Bonafide116/rfsom01/Hardware/Documents/Scheme-it-export-SOM-ZYNQ-2025-08-24-23-59.png

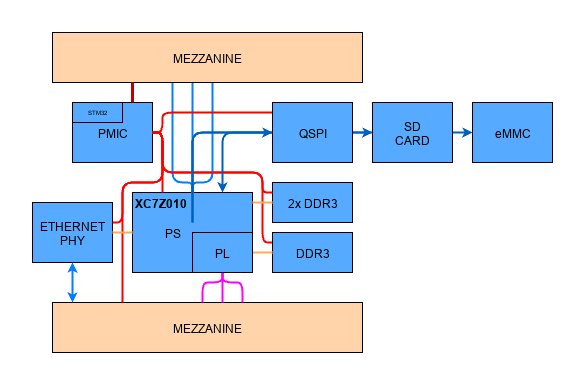
Hardware/Documents/Scheme-it-export-SOM-ZYNQ-2025-08-24-23-59.png
