Bonafide116/rfsom01/Hardware/Project Outputs/Documentation/Schematics/[WIP] RFSOM 01.pdf

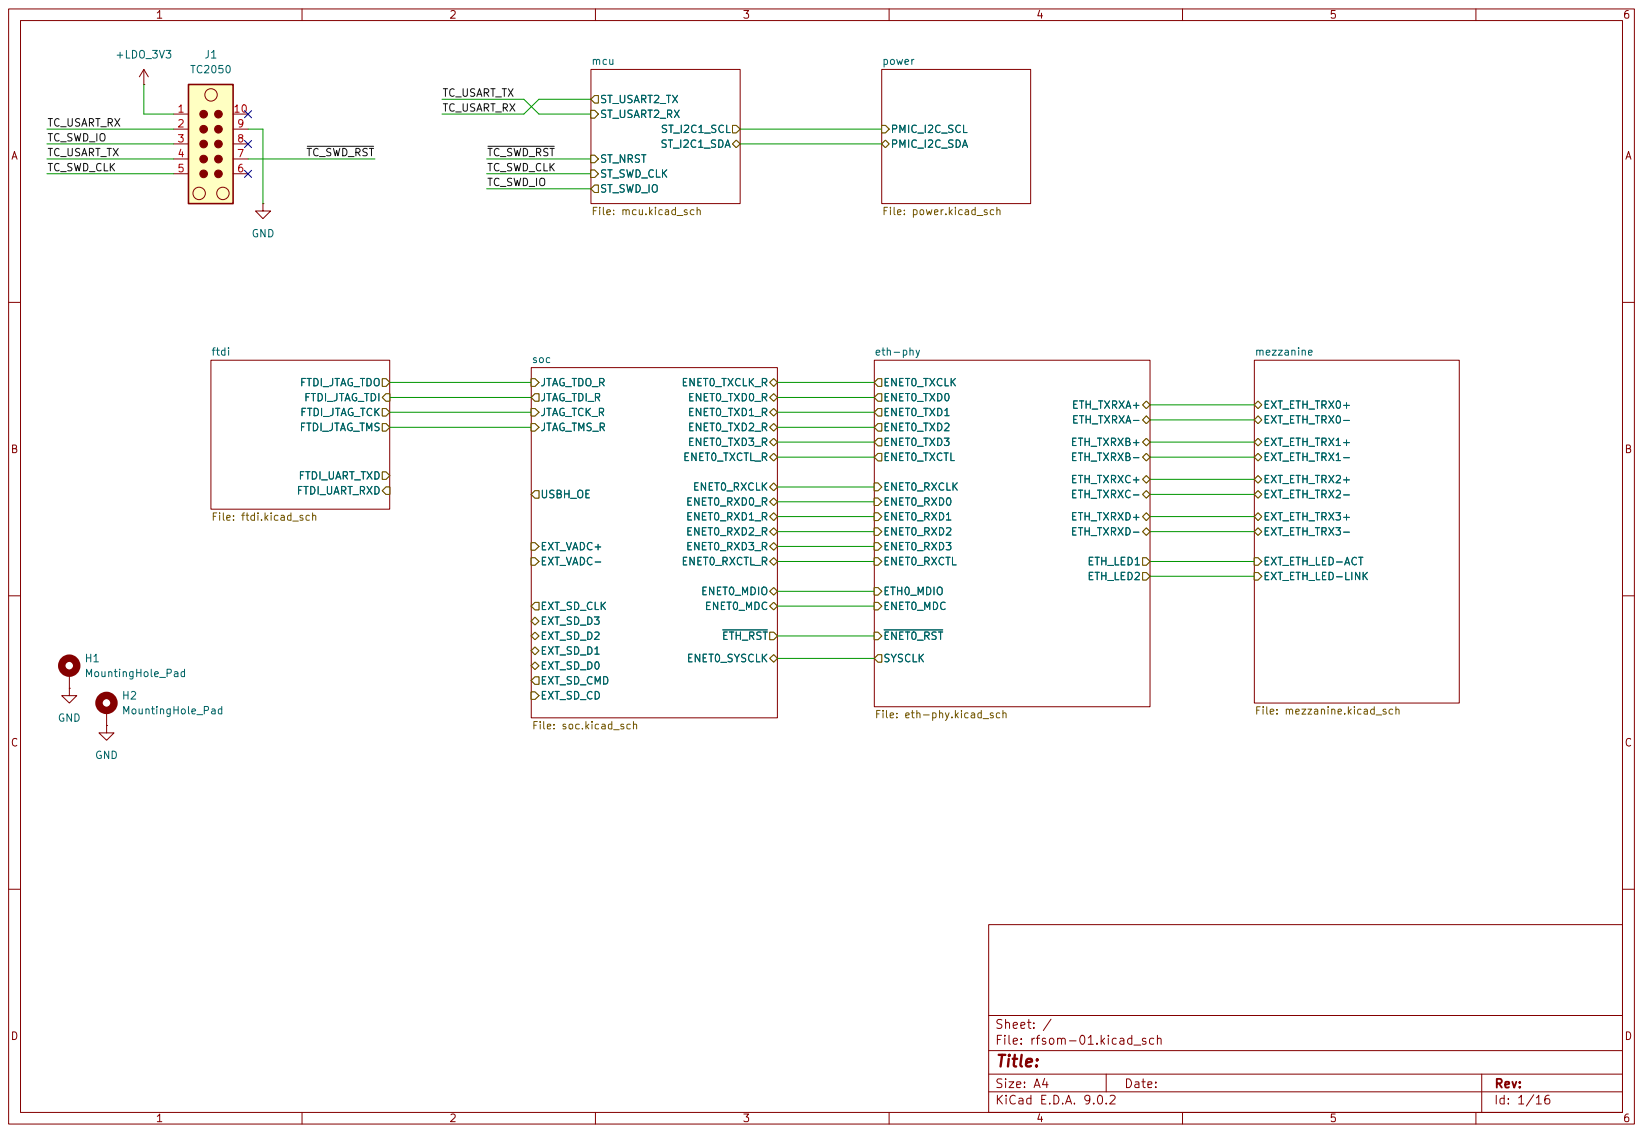
[picture p2: page 1]

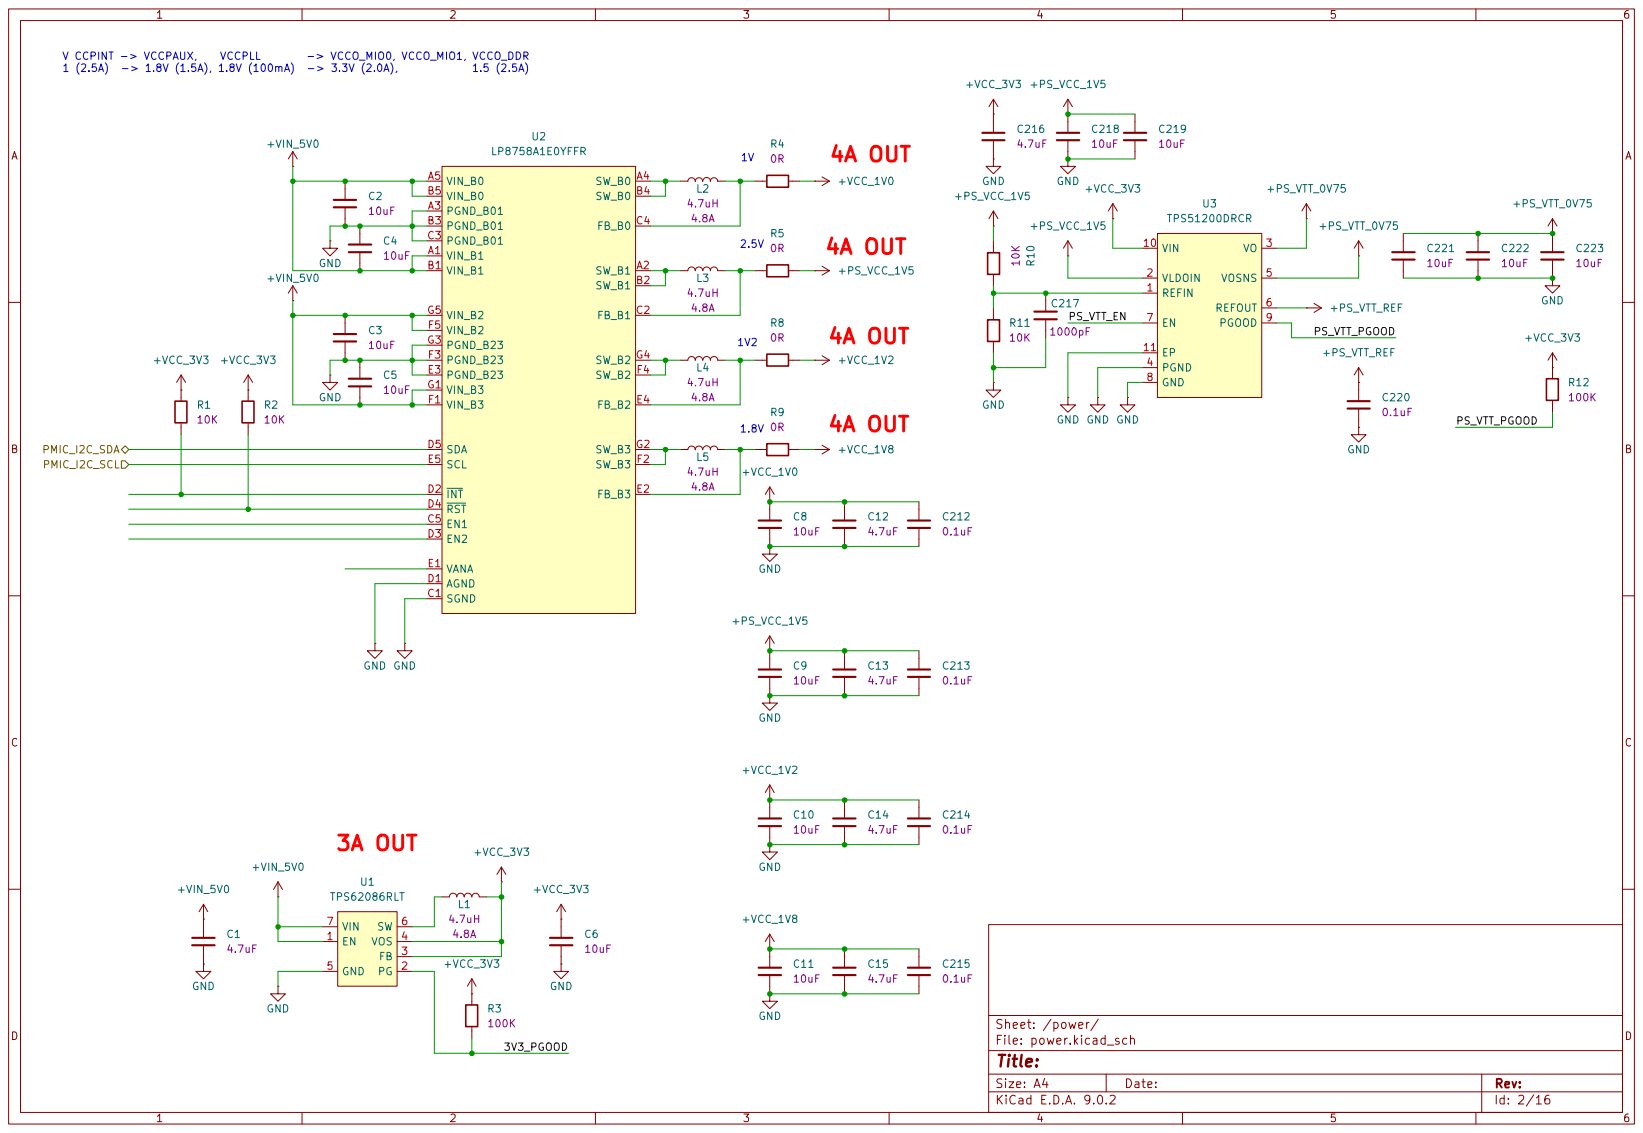
[picture p3: page 2]

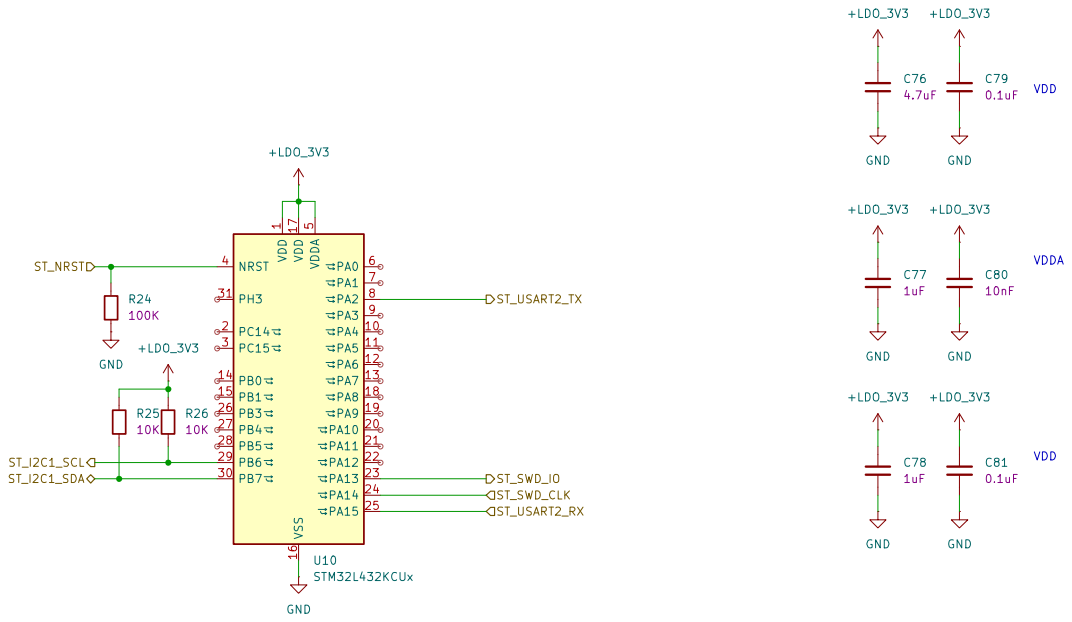
[picture p4: page 3]

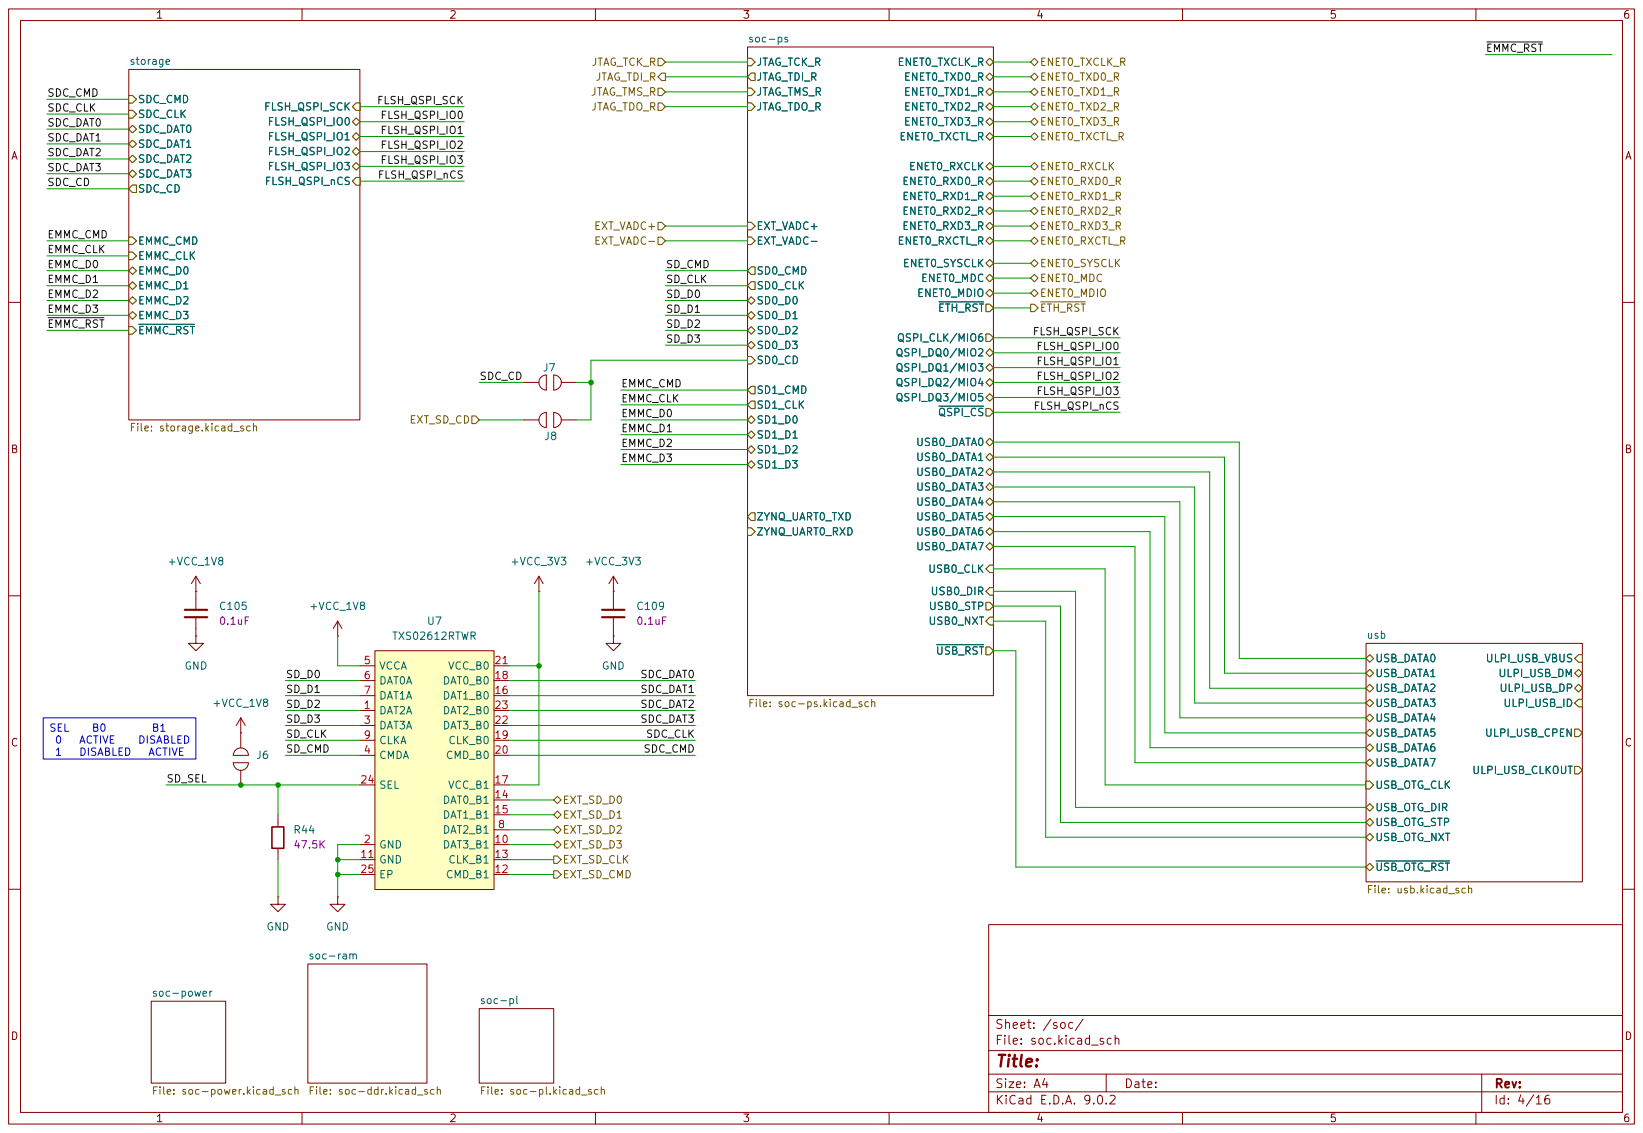
[picture p5: page 4]

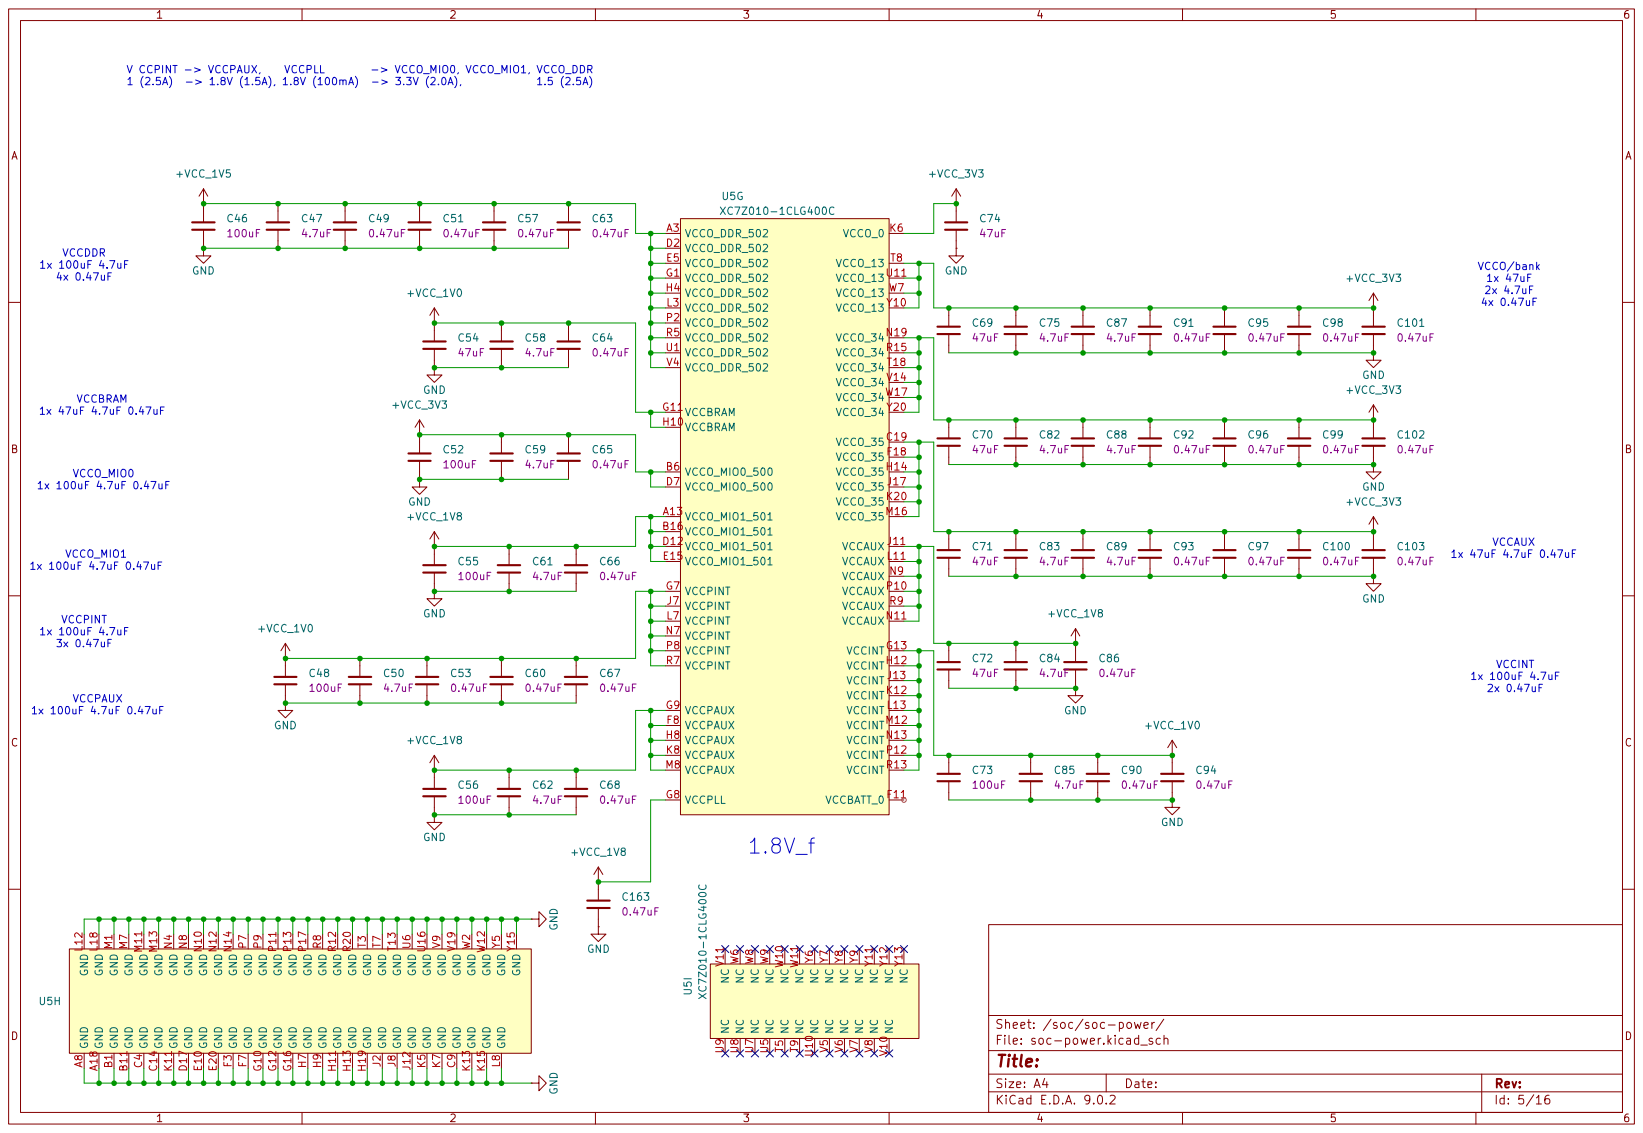
[picture p6: page 5]

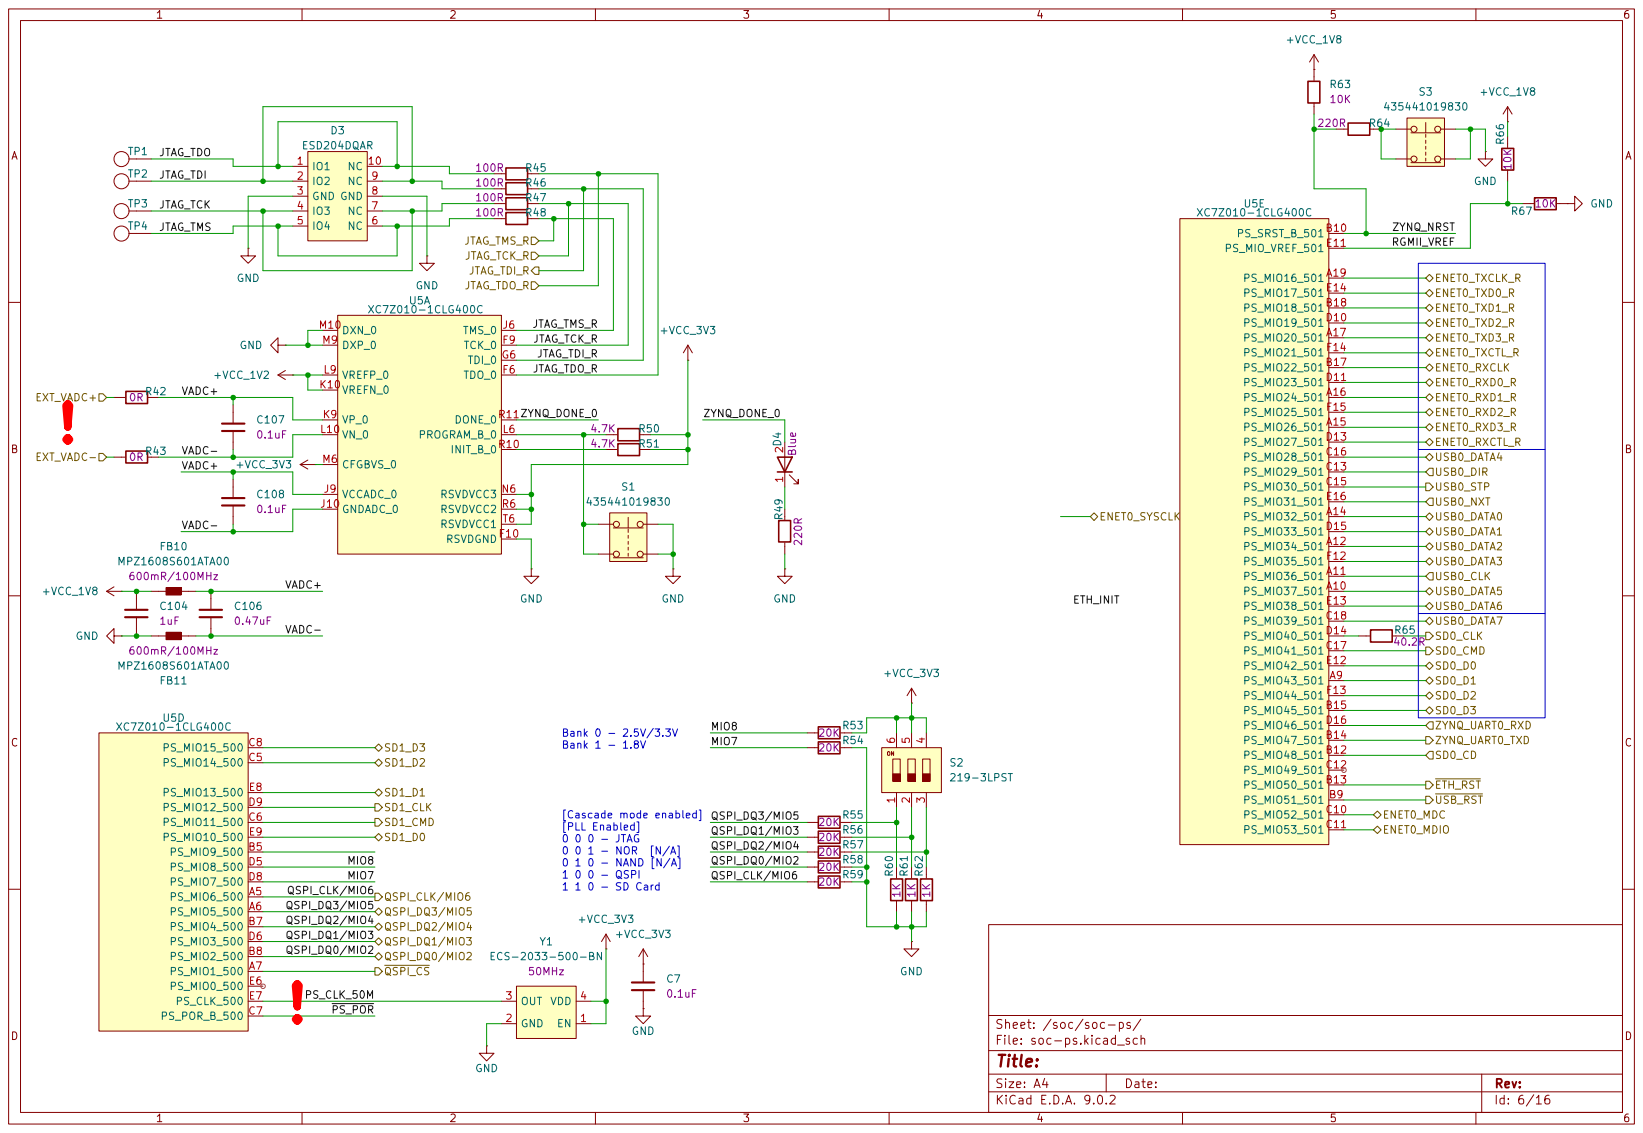
[picture p7: page 6]

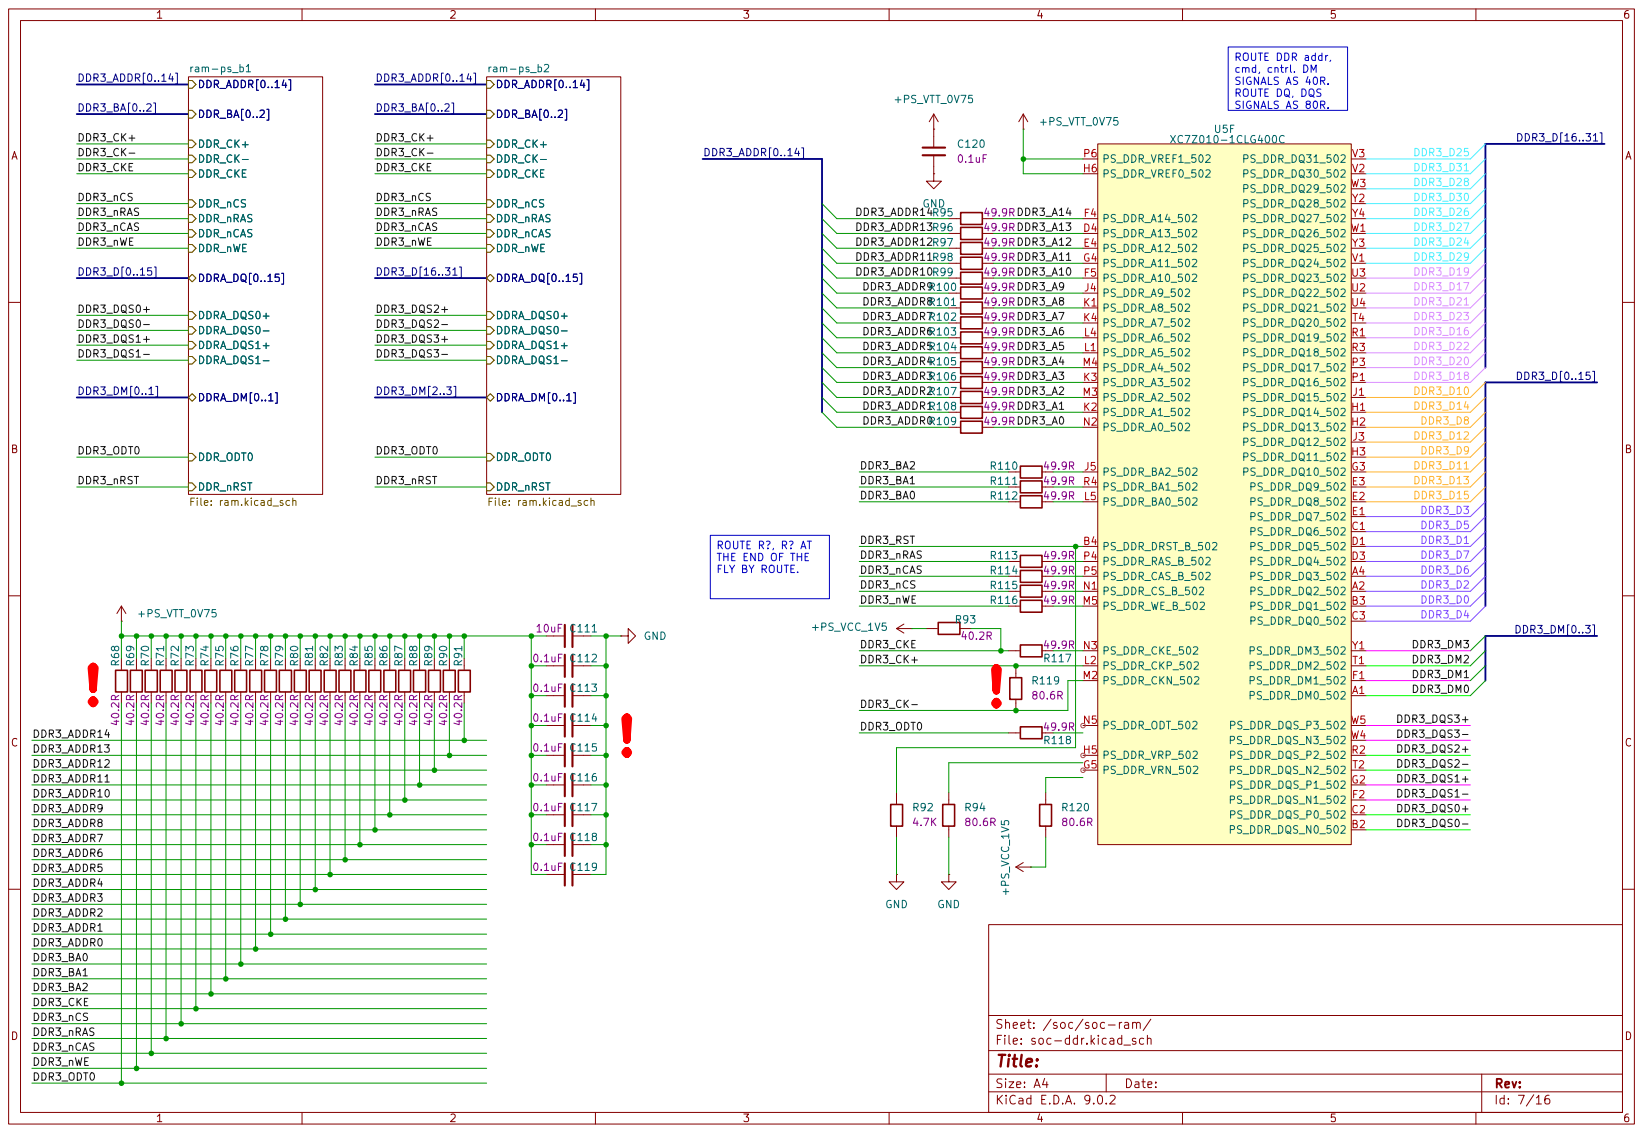
[picture p8: page 7]

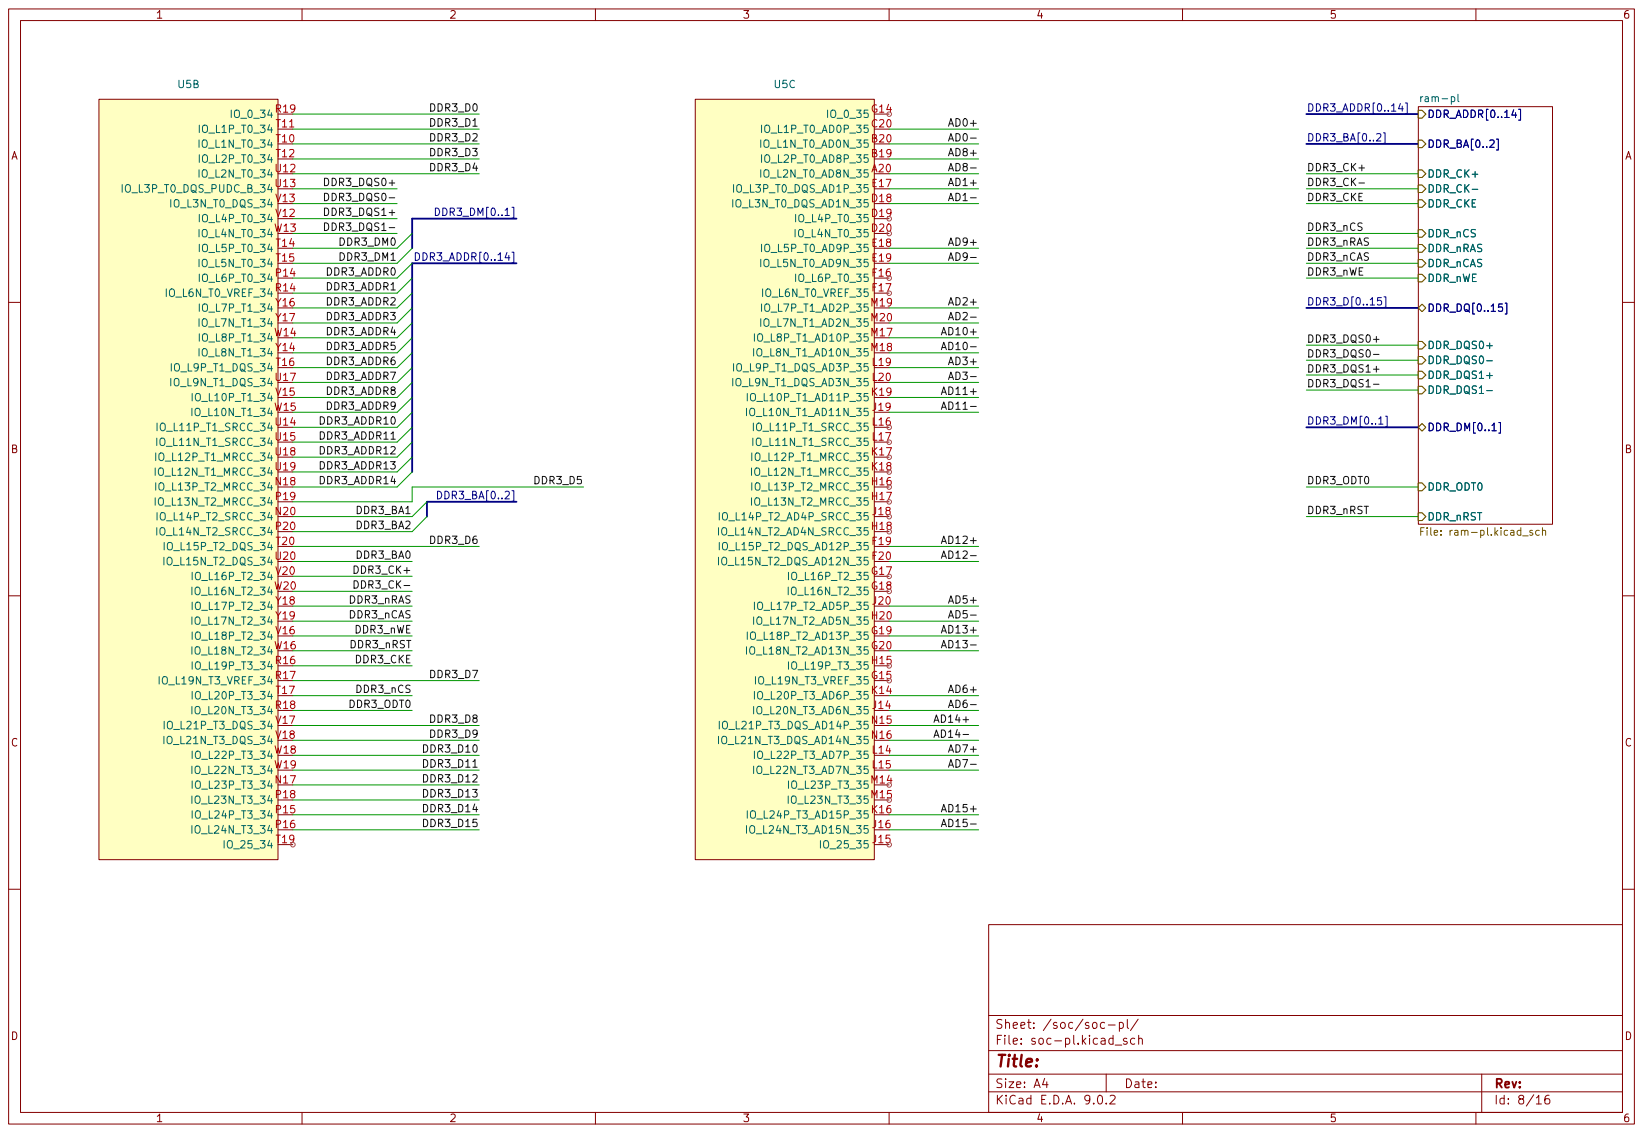
[picture p9: page 8]

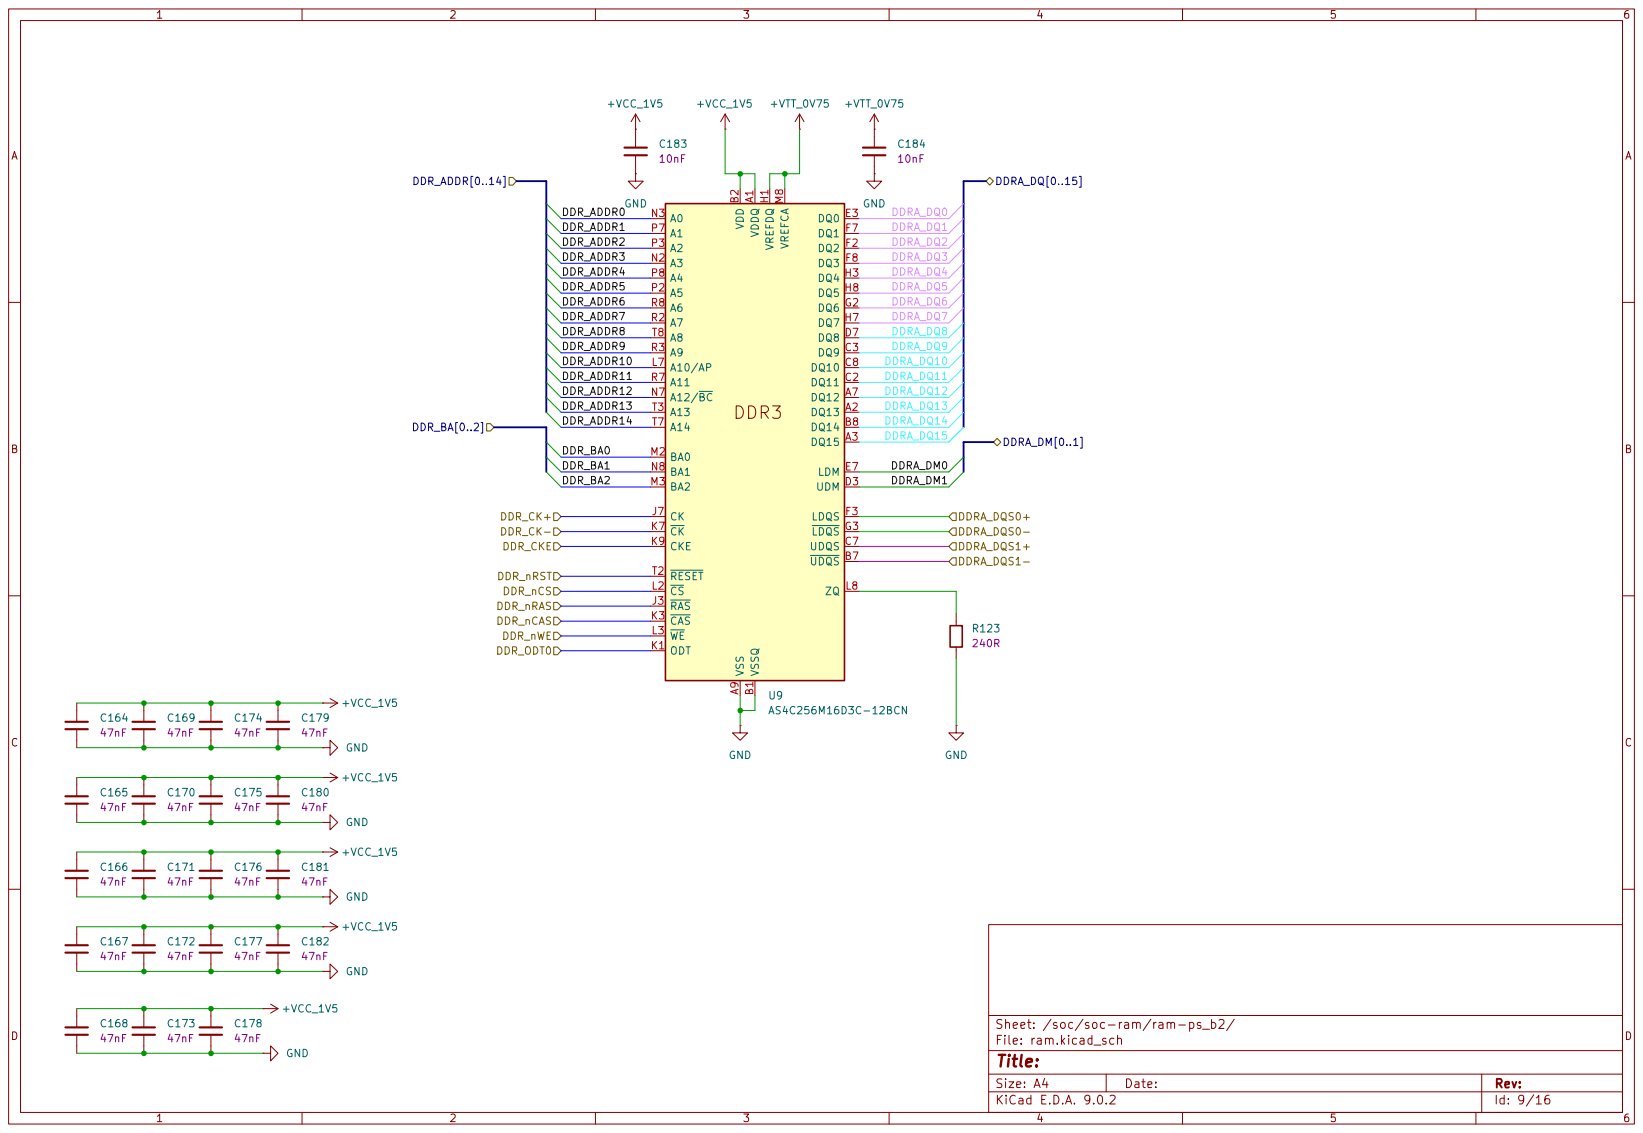
[picture p10: page 9]

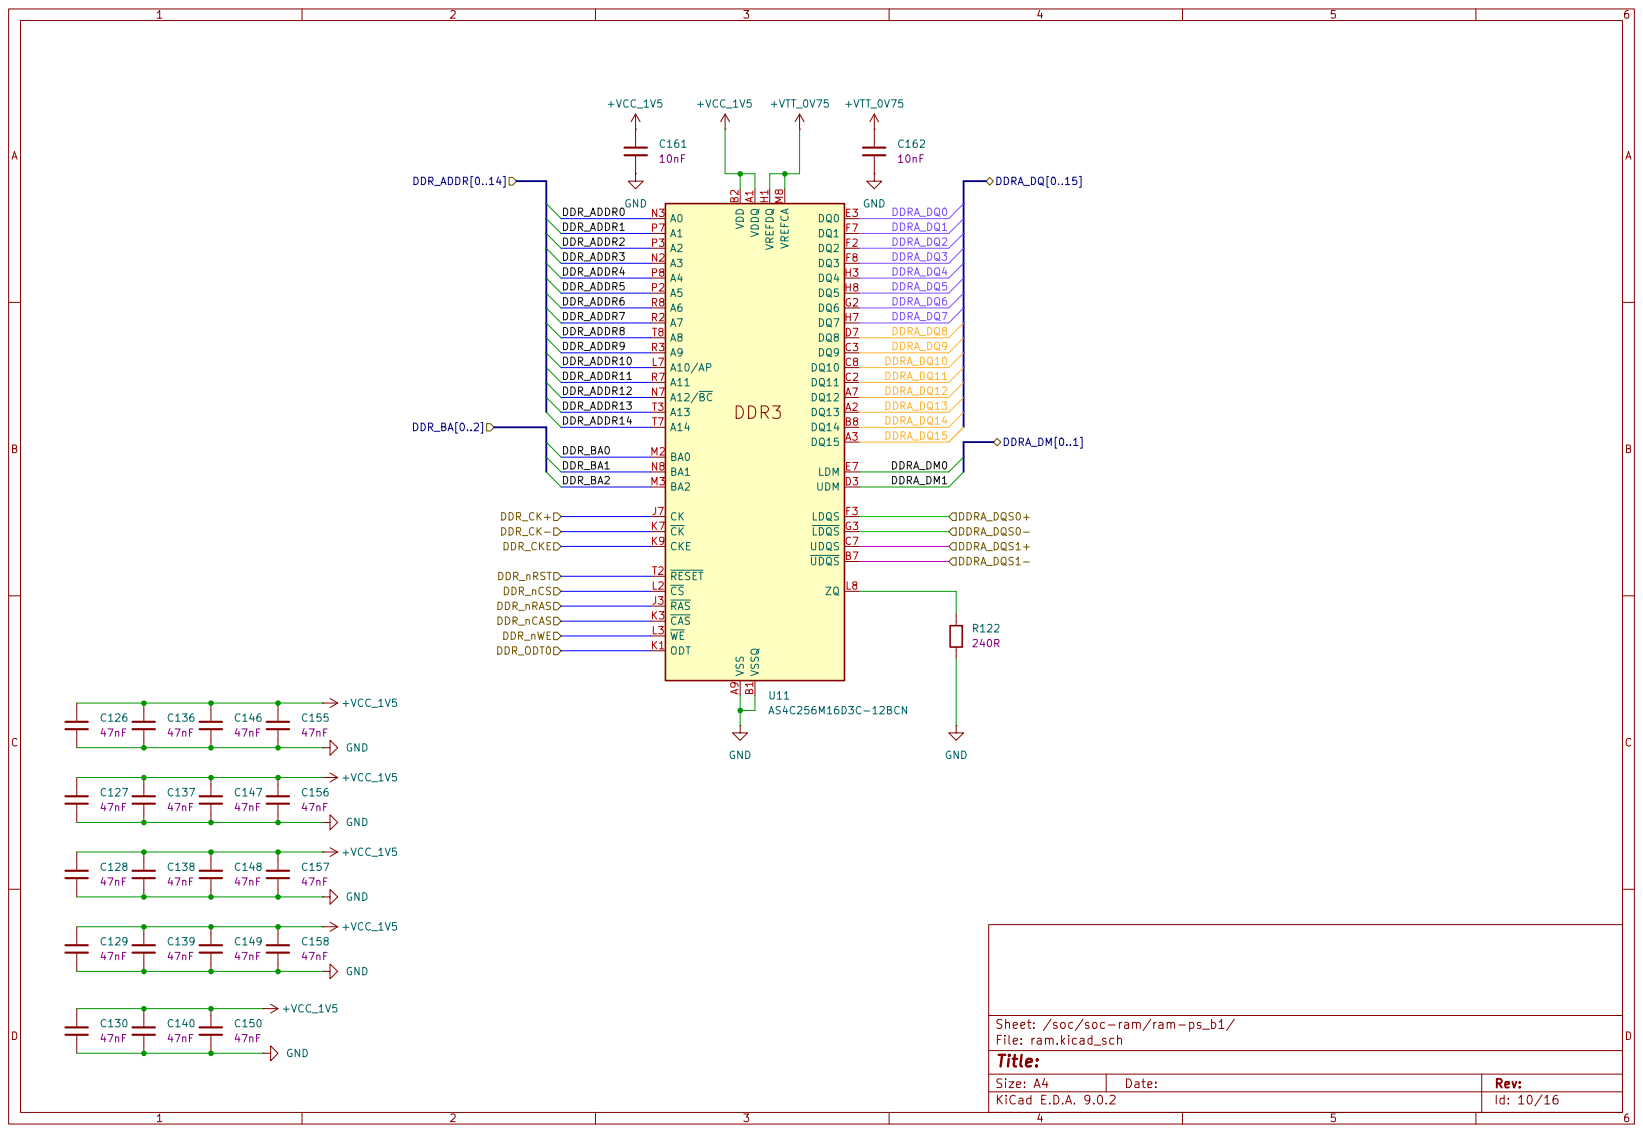
[picture p11: page 10]

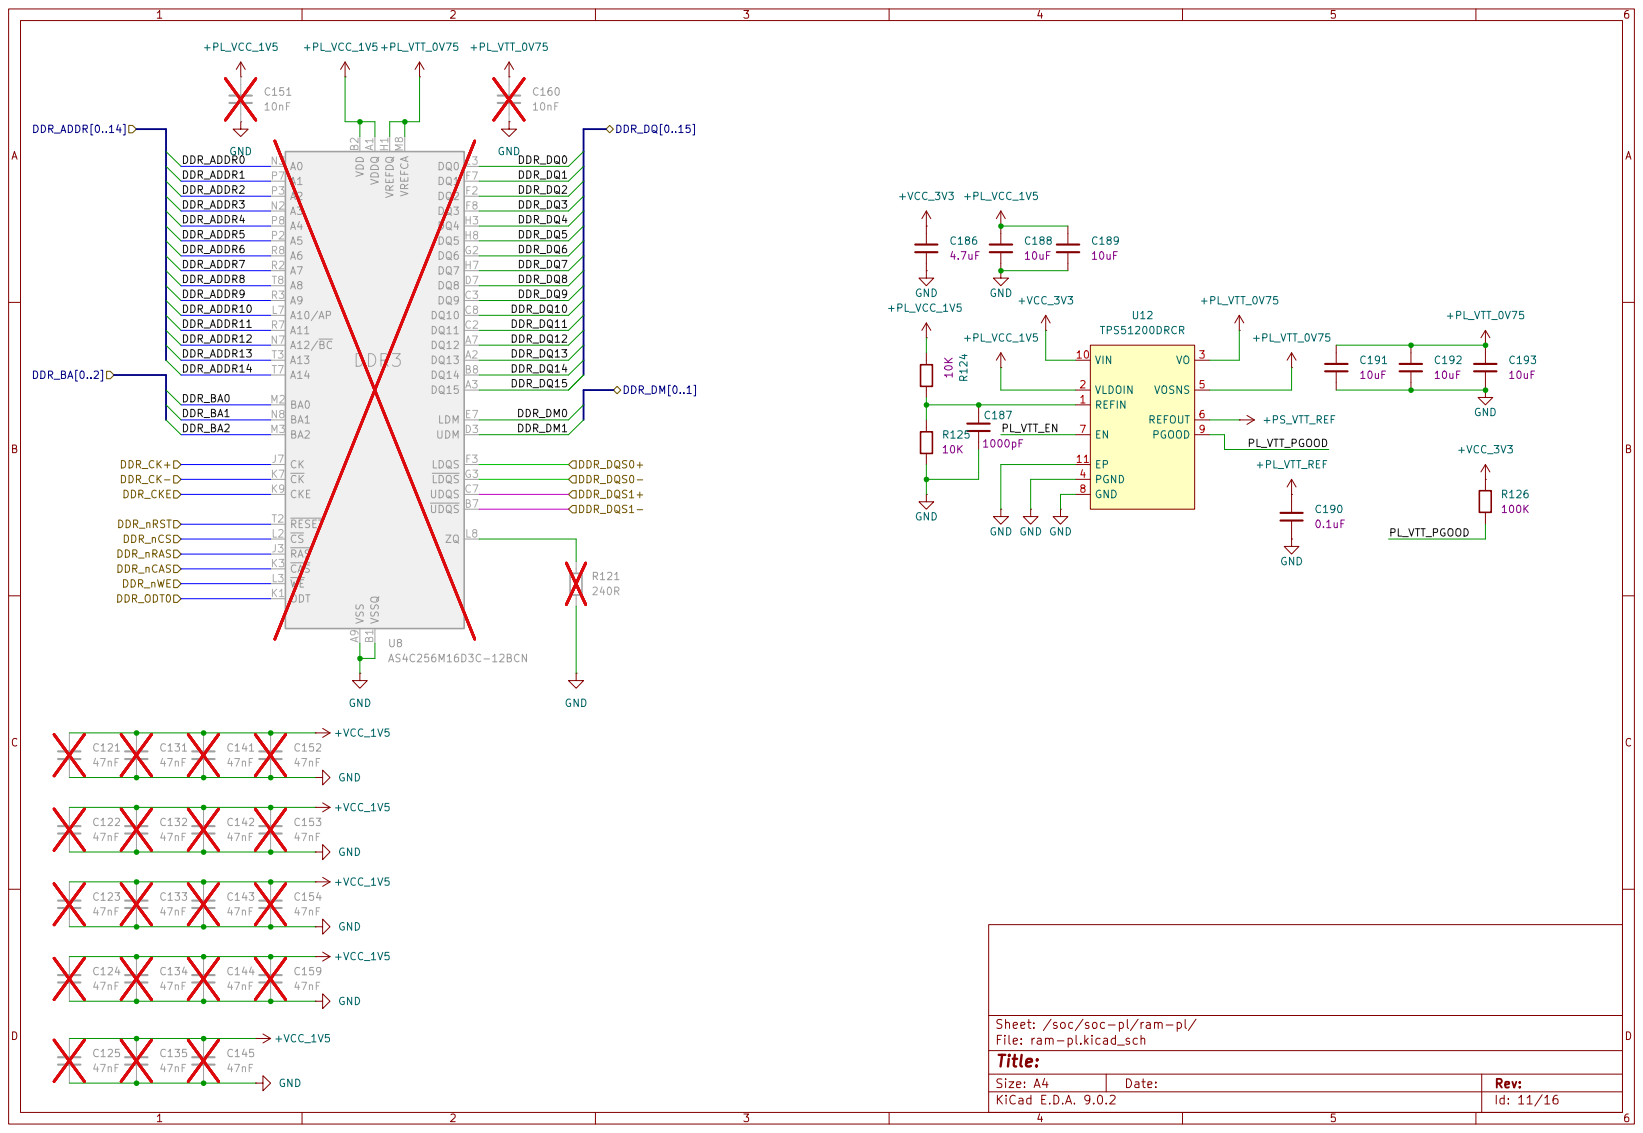
[picture p12: page 11]

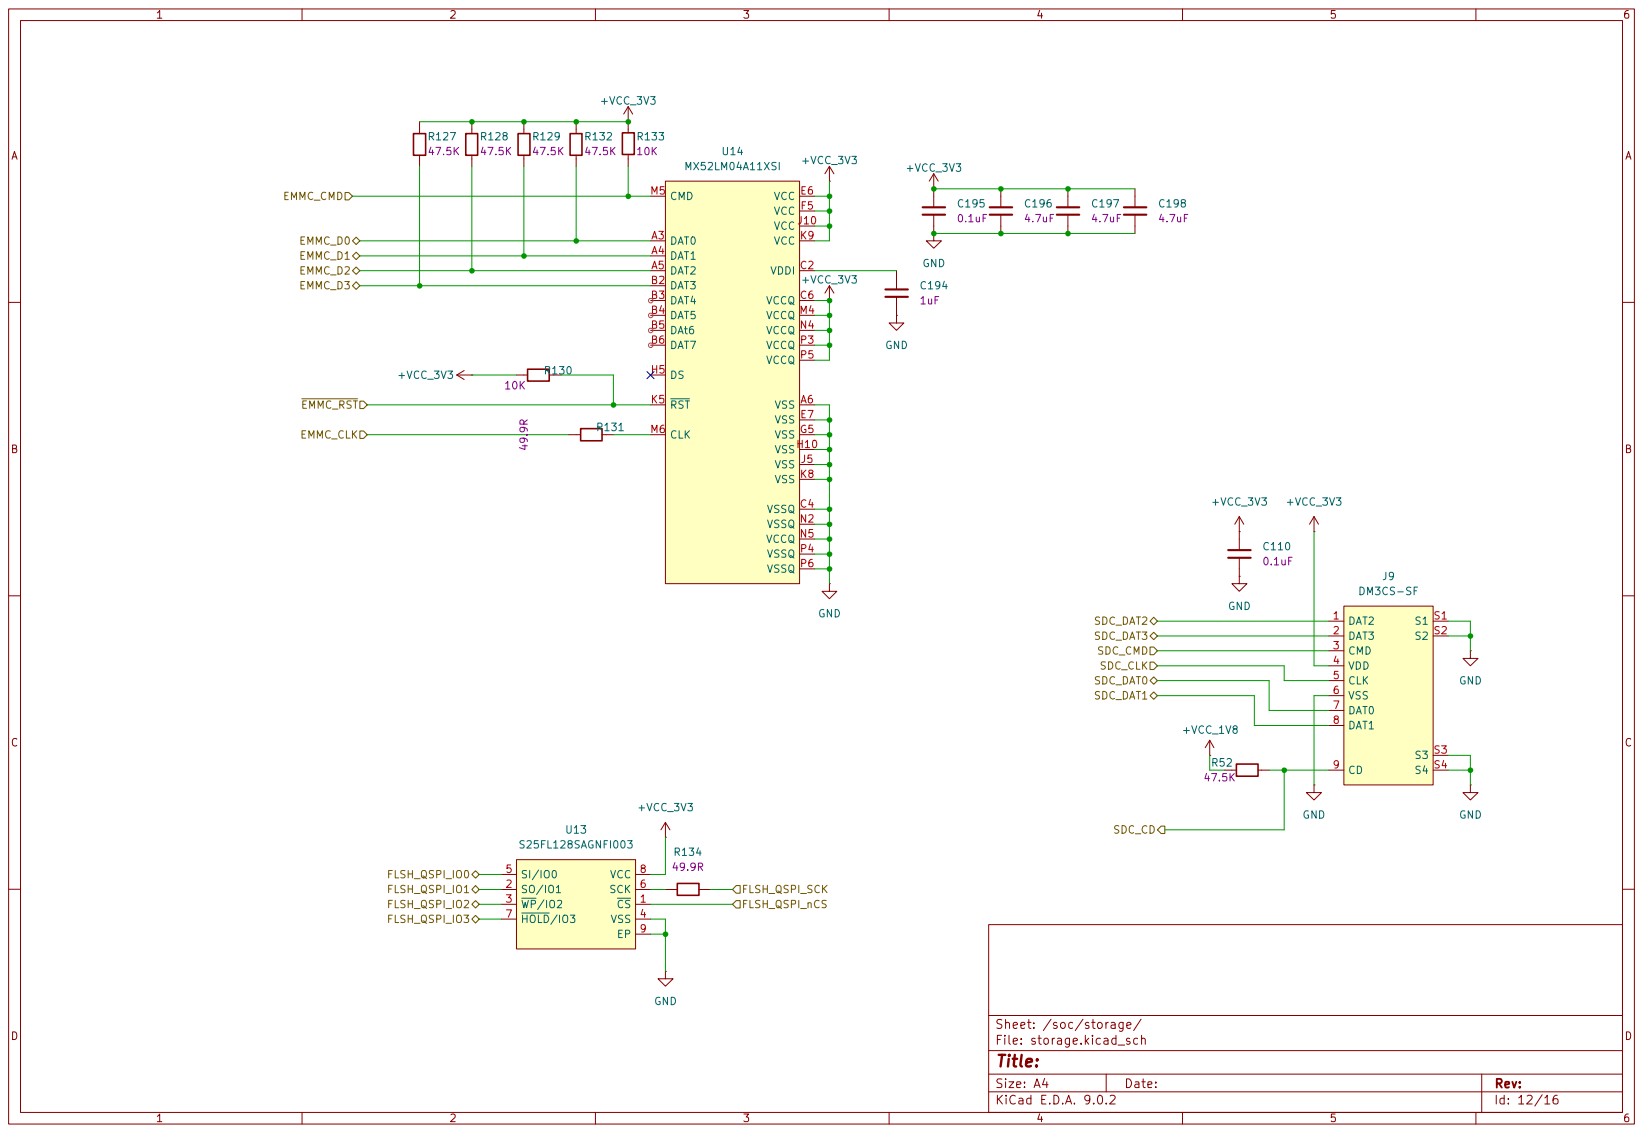
[picture p13: page 12]

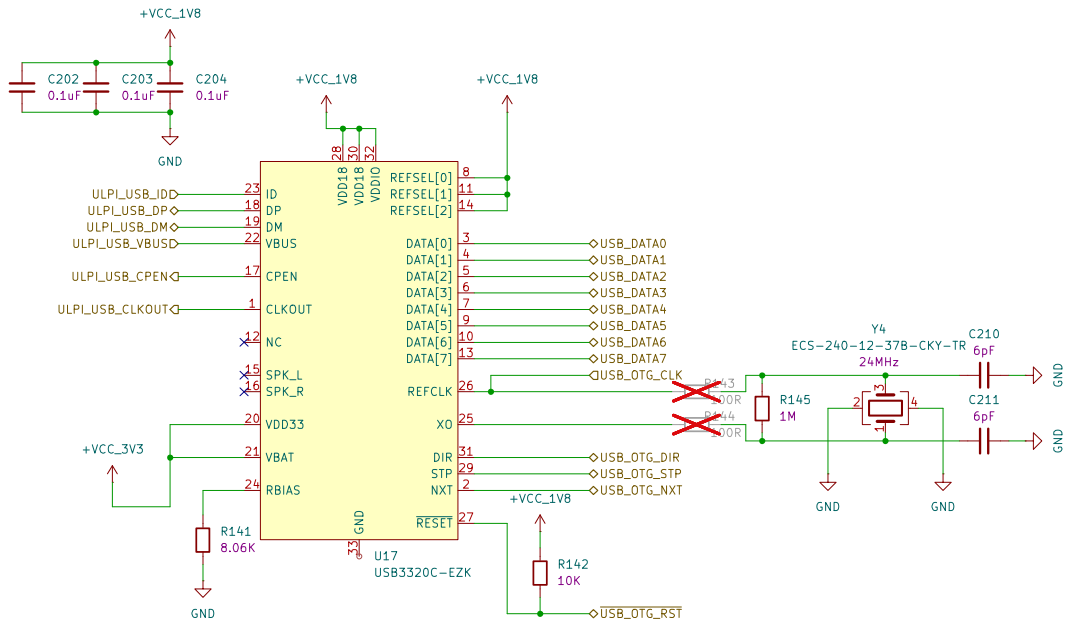
[picture p14: page 13]

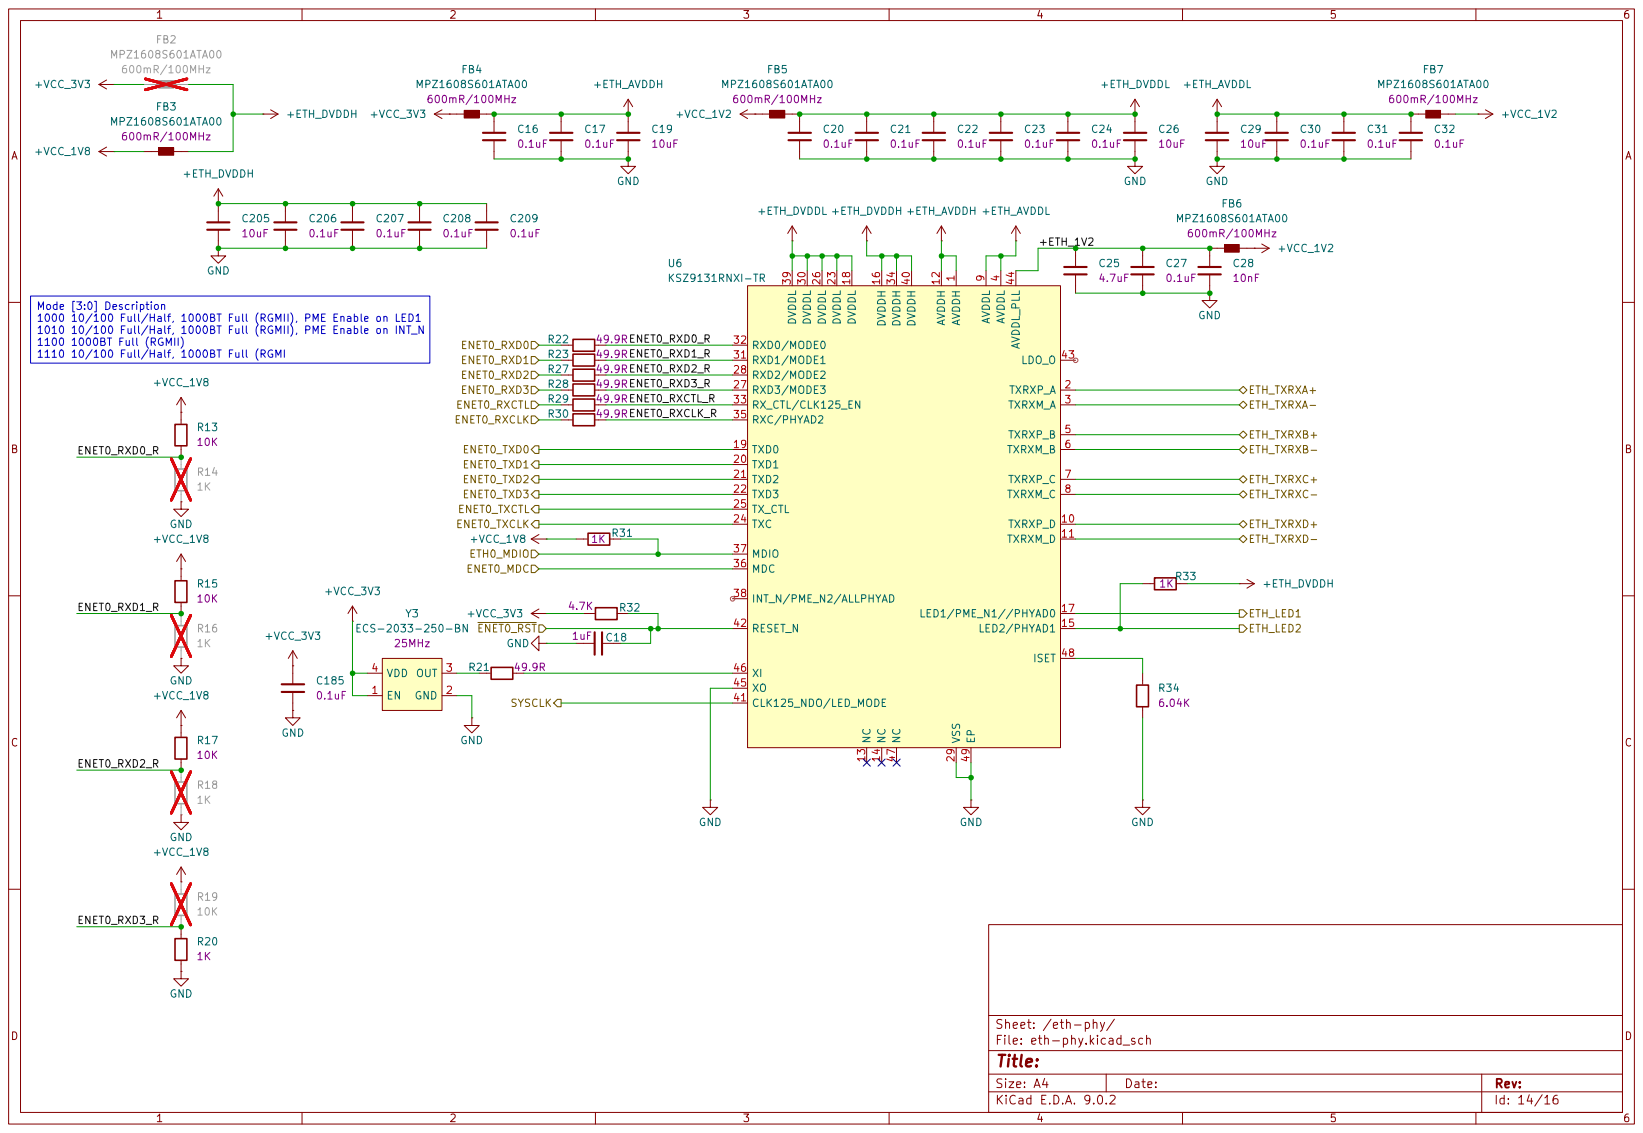
[picture p15: page 14]

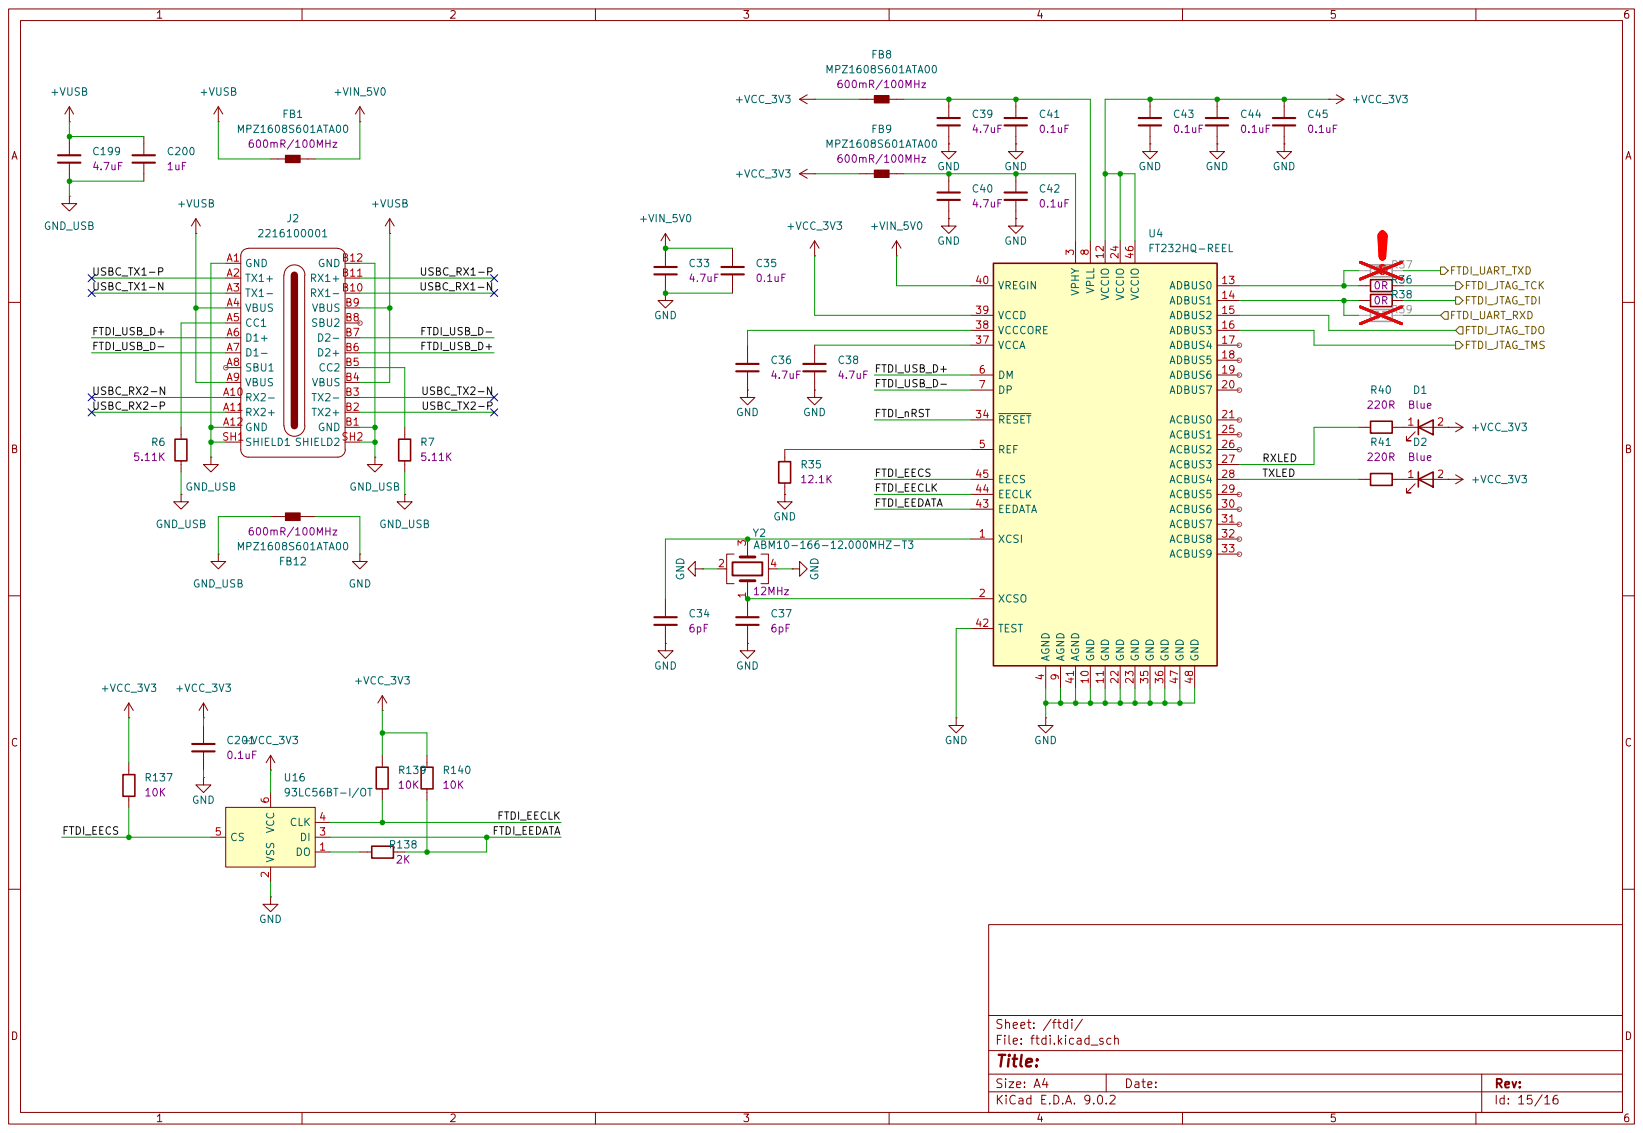
[picture p16: page 15]

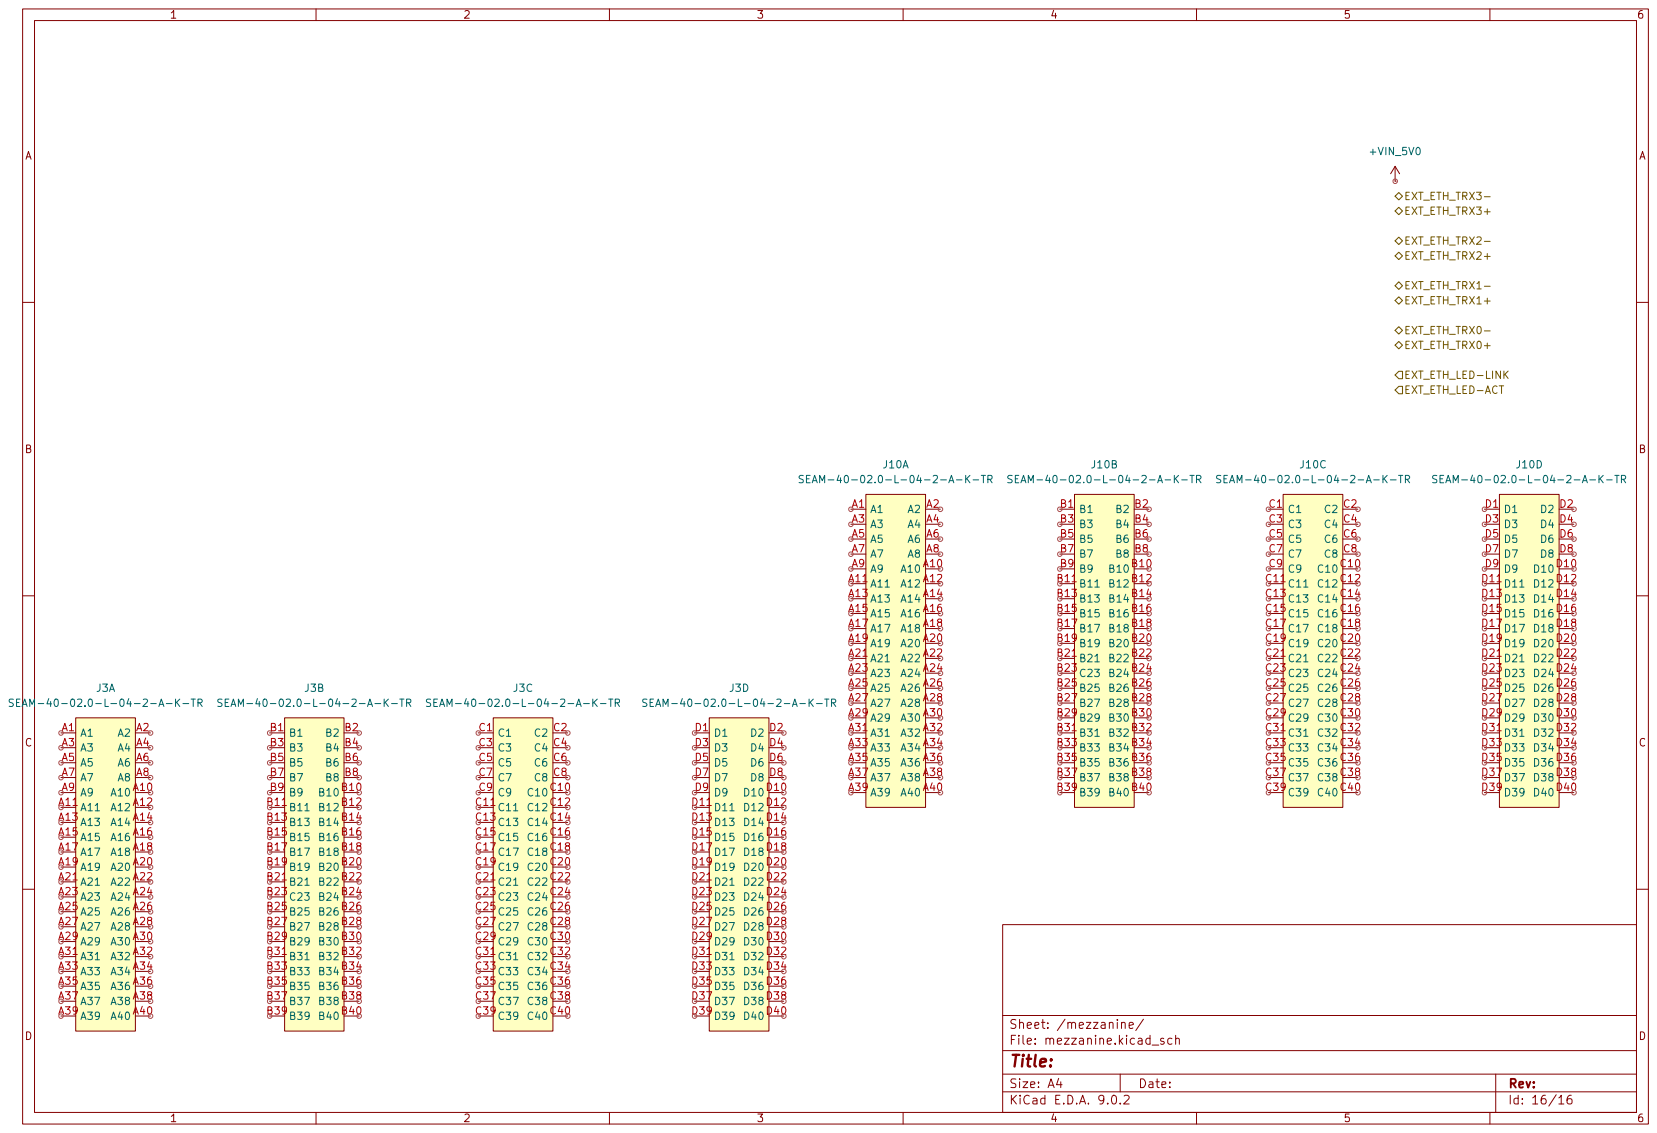
[picture p17: page 16]
