Bonafide116/rfsom01/Hardware/Design Files/rfsom-01/rfsom-01.kicad_pcb

## KiCad design Hardware/Design Files/rfsom-01/rfsom-01.kicad_pcb (2026-08-15)

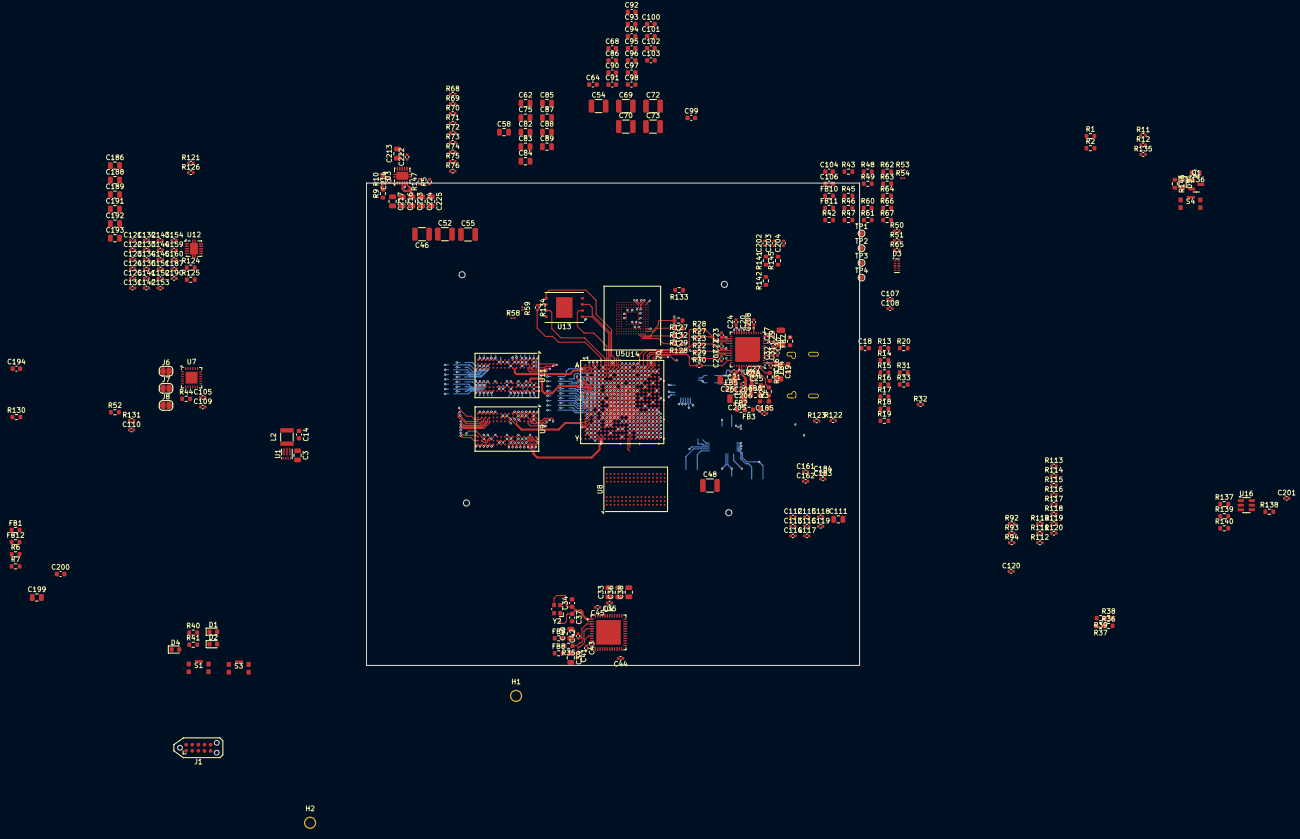
[picture p18: board rfsom-01.kicad_pcb from above]

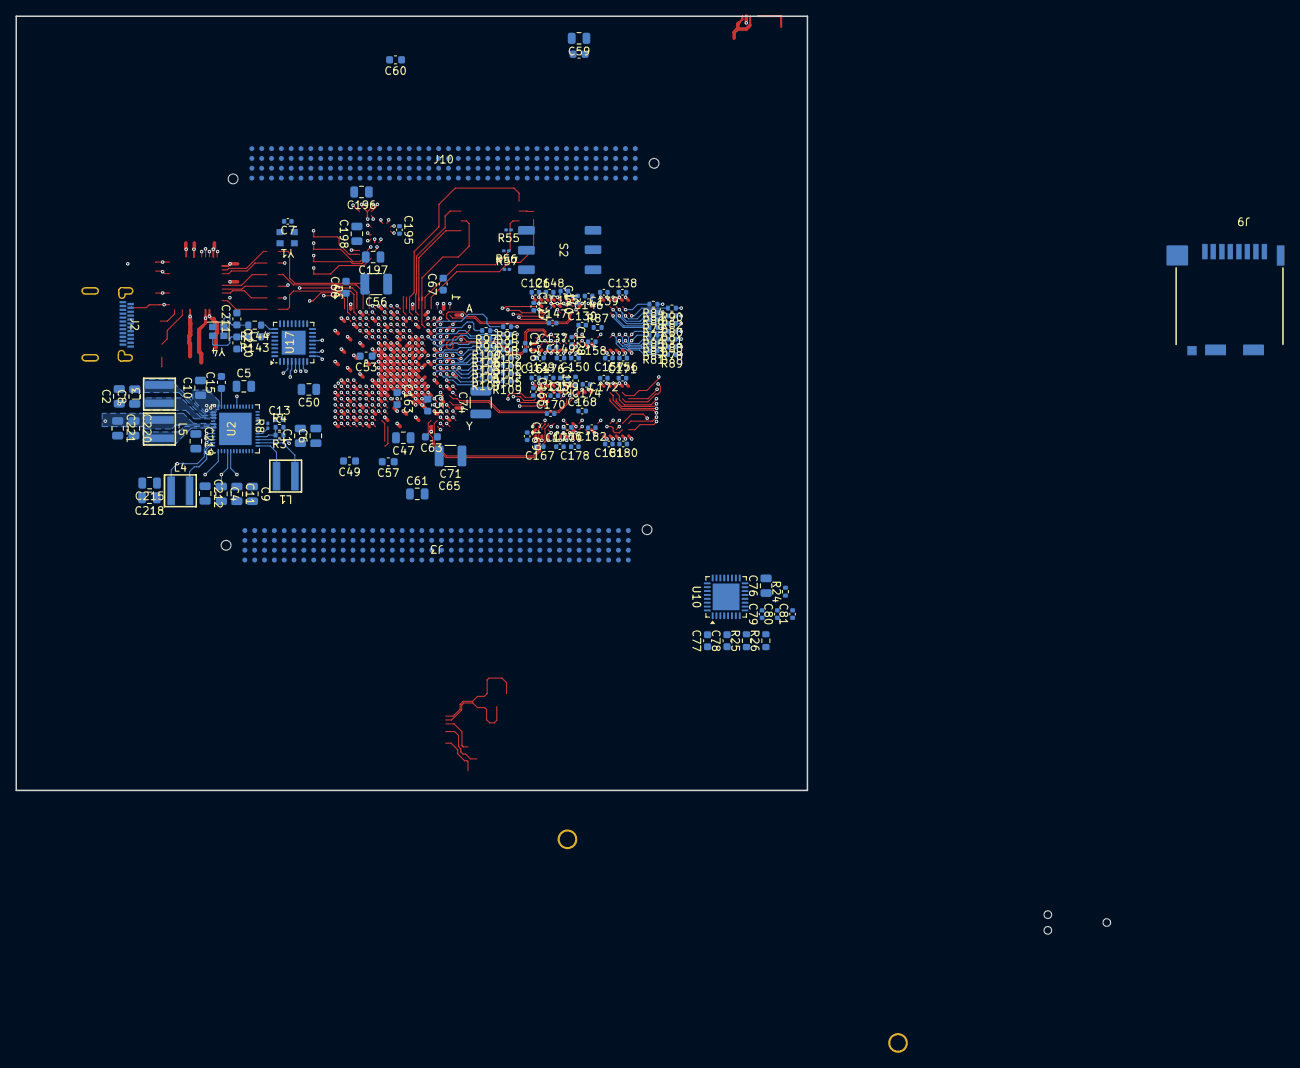
[picture p19: board rfsom-01.kicad_pcb from below]

Board: 10 copper layers, 102.2 x 100.0 mm, 432 parts (140 on the bottom side), 322 nets.

Parts:
C1, C8, C9, C10, C11, C47, C50, C58, C59, C61, C62, C75, C76, C82, C83, C84, C85, C87, C88, C89, C186, C212, C213, C218, C219, C221: CL21B475KPFNNNE; C_0805_2012Metric
C2, C4, C5, C6, C111, C188, C189, C191, C192, C193, C215, C216, C217, C220, C223, C224, C225: CL21B106KQQNFNE; C_0805_2012Metric
C3, C25, C33, C36, C38, C39, C40, C196, C197, C198, C199: CL21B475KAFNNNE; C_0805_2012Metric
C7, C13, C16, C17, C20, C21, C22, C23, C24, C27, C30, C31, C32, C35, C41, C42, C43, C44, C45, C79, C81, C105, C107, C108, C109, C110, C112, C113, C114, C115, C116, C117, C118, C119, C120, C185, C190, C195, C201, C202, C203, C204, C206, C207, C208, C209, C222: CL05B104KA5NNNC; C_0402_1005Metric
C14: GRM188R60G106ME47; C_0603_1608Metric
C15, C18, C77, C78, C104, C194, C200: CL10B105KA8NNNC; C_0603_1608Metric
C19, C26, C29, C205: CL31A106KBHNNNE; C_1206_3216Metric
C28, C80, C151, C160, C161, C162, C183, C184: CL05B103KB5NNNC; C_0402_1005Metric
C34, C37, C210, C211: CL10C060DB8NNNC; C_0603_1608Metric
C46, C48, C52, C55, C56, C73: GRM32EE70G107ME19K; C_1210_3225Metric
C49, C51, C53, C57, C60, C63, C64, C65, C66, C67, C68, C86, C90, C91, C92, C93, C94, C95, C96, C97, C98, C99, C100, C101, C102, C103, C106, C163: GRM188R70J474KA01D; C_0603_1608Metric
C54, C69, C70, C71, C72, C74: GRM32ER70J476ME20L; C_1210_3225Metric
C121, C122, C123, C124, C125, C126, C127, C128, C129, C130, C131, C132, C133, C134, C135, C136, C137, C138, C139, C140, C141, C142, C143, C144, C145, C146, C147, C148, C149, C150, C152, C153, C154, C155, C156, C157, C158, C159, C164, C165, C166, C167, C168, C169, C170, C171, C172, C173, C174, C175, C176, C177, C178, C179, C180, C181, C182: CL05B473KA5VPNC; C_0402_1005Metric
C187, C214: CL05B102KB5NNNC; C_0402_1005Metric
D1, D2, D4, D5: 150060BS75000; LED_0603_1608Metric
D3: ESD204DQAR; USON-10
FB1, FB2, FB3, FB4, FB5, FB6, FB7, FB8, FB9, FB10, FB11, FB12: MPZ1608S601ATA00; R_0603_1608Metric
H1, H2: MountingHole_Pad; MountingHole_2mm
J1: TC2050; Tag-Connect_TC2050-IDC-NL_2x05_P1.27mm_Vertical
J2: 2216100001
J3, J10: SEAM-40-02.0-L-04-2-A-K-TR; SEAM-40-XX.X-XXX-04-X-A-XX-XX
J6, J7, J8: SolderJumper-2_P1.3mm_Open_RoundedPad1.0x1.5mm
J9: DM3CS-SF
L1, L3, L4, L5: 74438357015; WE-MAPI
L2: DFE322512F-R47M=P2; IND_1210
Q1: BSS138; SOT-23
R1, R2, R9, R10, R13, R15, R17, R19, R25, R26, R63, R66, R67, R124, R125, R130, R133, R136, R137, R139, R140, R142: RC0603FR-0710KL; R_0603_1608Metric
R3: RC0402FR-13470KL; R_0402_1005Metric
R4, R5, R11, R12, R24, R126, R135, R147: RC0402FR-07100KL; R_0402_1005Metric
R6, R7: RC0603FR-135K11L; R_0603_1608Metric
R8, R53, R54, R55, R56, R57, R58, R59: RC0603FR-0720KL; R_0201_0603Metric
R14, R16, R18, R20, R31, R33, R60, R61, R62: RC0603FR-071KL; R_0603_1608Metric
R21: RC0603FR-0749R9L; R_0603_1608Metric
R22, R23, R27, R28, R29, R30, R95, R96, R97, R98, R99, R100, R101, R102, R103, R104, R105, R106, R107, R108, R109, R110, R111, R112, R113, R114, R115, R116, R117, R118, R131, R134: RC0402FR-0722RL; R_0402_1005Metric
R32, R50, R51, R92: RES_01; R_0402_1005Metric
R34: RC0603FR-076K04L; R_0603_1608Metric
R35: RES_01; R_0603_1608Metric
R36, R37, R38, R39, R42, R43: RC0603JR-070RL; R_0603_1608Metric
R40, R41, R49, R64, R146: RC0603FR-07220RL; R_0603_1608Metric
R44, R52, R127, R128, R129, R132: RC0603FR-0747K5L; R_0603_1608Metric
R45, R46, R47, R48, R143, R144: RC0402FR-07100RL; R_0603_1608Metric
R65, R68, R69, R70, R71, R72, R73, R74, R75, R76, R77, R78, R79, R80, R81, R82, R83, R84, R85, R86, R87, R88, R89, R90, R91, R93: RT0402FRE0740R2L; R_0402_1005Metric
R94, R119, R120: RC0402FR-0780R6L; R_0402_1005Metric
R121, R122, R123: RC0402FR-07240RL; R_0402_1005Metric
R138: RC0603FR-072KL; R_0603_1608Metric
R141: RC0603FR-078K06L; R_0603_1608Metric
R145: RC0603FR-071ML; R_0603_1608Metric
S1, S3, S4: 435441019830
S2: 219-3LPST
TP1, TP2, TP3, TP4: TestPoint_Pad_D1.0mm
U1: TPS62086RLT; RLT0007A
U2: TPS65218D0RSLT; RSL0048G
U3, U12: TPS51200DRCR; VSON-10-1EP_3x3mm_P0.5mm_EP1.65x2.4mm
U4: FT232HQ-REEL; QFN-48-1EP_7x7mm_P0.5mm_EP5.1x5.1mm
U5: XC7Z010-1CLG400C; CLG400
U6: KSZ9131RNXI-TR; MLPQ-48-1EP_7x7mm_P0.5mm
U7: TXS02612RTWR; QFN-24-1EP_4x4mm_P0.5mm
U8, U9, U11: AS4C256M16D3C-12BCN; BGA-96_9.0x13.0mm_Layout2x3x16_P0.8mm
U10: STM32L432KCUx; QFN-32-1EP_5x5mm_P0.5mm_EP3.45x3.45mm
U13: S25FL128SAGNFI003; PG-WSON-8_EP
U14: MX52LM04A11XSI; LFBGA-153_11.5x13mm_Layout14x14_P0.5mm
U16: 93LC56BT-I/OT; SOT-23-6
U17: USB3320C-EZK; QFN-32-1EP_5x5mm_P0.5mm
Y1: ECS-2033-500-BN; ECS-2033
Y2: ABM10-166-12.000MHZ-T3; Crystal_SMD_Abracon_ABM10-4Pin_2.5x2.0mm
Y3: ECS-2033-250-BN; ECS-2033
Y4: ECS-240-12-37B-CKY-TR; ECX-1637B

Connections:
+ETH_AVDDH: C16.1, C17.1, C19.1, FB4.2, U6.1 (AVDDH), U6.12 (AVDDH)
+ETH_AVDDL: C29.1, C30.1, C31.1, C32.1, FB7.1, U6.4 (AVDDL), U6.9 (AVDDL)
+ETH_DVDDH: C205.1, C206.1, C207.1, C208.1, C209.1, FB2.2, FB3.2, R33.2, U6.16 (DVDDH), U6.34 (DVDDH), U6.40 (DVDDH)
+ETH_DVDDL: C20.1, C21.1, C22.1, C23.1, C24.1, C26.1, FB5.2, U6.18 (DVDDL), U6.23 (DVDDL), U6.26 (DVDDL), U6.30 (DVDDL), U6.39 (DVDDL)
+LDO_3V3: C14.1, C76.1, C77.1, C78.1, C79.1, C80.1, C81.1, J1.1, L2.2, Q1.3 (D), R1.1, R2.1, R5.2, R11.1, R12.1, R25.1, R26.1, R135.1, R136.1, U1.3 (FB), U1.4 (VOS), U10.1 (VDD), U10.5 (VDDA), U10.17 (VDD)
+PL_VCC_1V5: C151.1, C188.1, C189.1, R124.1, U8.A1 (VDDQ), U8.A8 (VDDQ), U8.B2 (VDD), U8.C1 (VDDQ), U8.C9 (VDDQ), U8.D2 (VDDQ), U8.D9 (VDD), U8.E9 (VDDQ), U8.F1 (VDDQ), U8.G7 (VDD), U8.H2 (VDDQ), U8.H9 (VDDQ), U8.K2 (VDD), U8.K8 (VDD), U8.N1 (VDD), U8.N9 (VDD), U8.R1 (VDD), U8.R9 (VDD), U12.2 (VLDOIN)
+PL_VTT_0V75: C160.1, C191.1, C192.1, C193.1, U8.H1 (VREFDQ), U8.M8 (VREFCA), U12.3 (VO), U12.5 (VOSNS)
+PS_VCC_1V5: C216.1, C217.1, R9.1, R93.1, R120.2, U3.2 (VLDOIN)
+PS_VTT_0V75: C111.1, C112.1, C113.1, C114.1, C115.1, C116.1, C117.1, C118.1, C119.1, C120.1, C223.1, C224.1, C225.1, R68.1, R69.1, R70.1, R71.1, R72.1, R73.1, R74.1, R75.1, R76.1, R77.1, R78.1, R79.1, R80.1, R81.1, R82.1, R83.1, R84.1, R85.1, R86.1, R87.1, R88.1, R89.1, R90.1, R91.1, U3.3 (VO), U3.5 (VOSNS), U5.H6 (PS_DDR_VREF0_502), U5.P6 (PS_DDR_VREF1_502)
+PS_VTT_REF: C222.1, U3.6 (REFOUT), U12.6 (REFOUT)
+VCC_1V0: C48.1, C50.1, C53.1, C54.1, C58.1, C60.1, C64.1, C67.1, C73.1, C85.1, C90.1, C94.1, C215.1, C218.1, L4.1, U2.47 (FB1), U5.G7 (VCCPINT), U5.G11 (VCCBRAM), U5.G13 (VCCINT), U5.H10 (VCCBRAM), U5.H12 (VCCINT), U5.J7 (VCCPINT), U5.J13 (VCCINT), U5.K12 (VCCINT), U5.L7 (VCCPINT), U5.L13 (VCCINT), U5.M12 (VCCINT), U5.N7 (VCCPINT), U5.N13 (VCCINT), U5.P8 (VCCPINT), U5.P12 (VCCINT), U5.R7 (VCCPINT), U5.R13 (VCCINT)
+VCC_1V2: C220.1, C221.1, FB5.1, FB6.2, FB7.2, L5.1, U2.41 (FB2), U5.K10 (VREFN_0), U5.L9 (VREFP_0)
+VCC_1V5: C2.1, C8.1, C46.1, C47.1, C49.1, C51.1, C57.1, C63.1, C121.1, C122.1, C123.1, C124.1, C125.1, C126.1, C127.1, C128.1, C129.1, C130.1, C131.1, C132.1, C133.1, C134.1, C135.1, C136.1, C137.1, C138.1, C139.1, C140.1, C141.1, C142.1, C143.1, C144.1, C145.1, C146.1, C147.1, C148.1, C149.1, C150.1, C152.1, C153.1, C154.1, C155.1, C156.1, C157.1, C158.1, C159.1, C161.1, C164.1, C165.1, C166.1, C167.1, C168.1, C169.1, C170.1, C171.1, C172.1, C173.1, C174.1, C175.1, C176.1, C177.1, C178.1, C179.1, C180.1, C181.1, C182.1, C183.1, L3.1, U2.31 (IN_LS1), U2.39 (FB3), U5.A3 (VCCO_DDR_502), U5.D2 (VCCO_DDR_502), U5.E5 (VCCO_DDR_502), U5.G1 (VCCO_DDR_502), U5.H4 (VCCO_DDR_502), U5.L3 (VCCO_DDR_502), U5.P2 (VCCO_DDR_502), U5.R5 (VCCO_DDR_502), U5.U1 (VCCO_DDR_502), U5.V4 (VCCO_DDR_502), U9.A1 (VDDQ), U9.A8 (VDDQ), U9.B2 (VDD), U9.C1 (VDDQ), U9.C9 (VDDQ), U9.D2 (VDDQ), U9.D9 (VDD), U9.E9 (VDDQ), U9.F1 (VDDQ), U9.G7 (VDD), U9.H2 (VDDQ), U9.H9 (VDDQ), U9.K2 (VDD), U9.K8 (VDD), U9.N1 (VDD), U9.N9 (VDD), U9.R1 (VDD), U9.R9 (VDD), U11.A1 (VDDQ), U11.A8 (VDDQ), U11.B2 (VDD), U11.C1 (VDDQ), U11.C9 (VDDQ), U11.D2 (VDDQ), U11.D9 (VDD), U11.E9 (VDDQ), U11.F1 (VDDQ), U11.G7 (VDD), U11.H2 (VDDQ), U11.H9 (VDDQ), U11.K2 (VDD), U11.K8 (VDD), U11.N1 (VDD), U11.N9 (VDD), U11.R1 (VDD), U11.R9 (VDD)
+VCC_1V8: C4.1, C55.1, C56.1, C61.1, C62.1, C66.1, C68.1, C72.1, C84.1, C86.1, C104.1, C105.1, C163.1, C202.1, C203.1, C204.1, FB3.1, FB10.1, J6.2, R13.1, R15.1, R17.1, R19.1, R31.1, R52.1, R63.1, R66.1, R142.1, U2.4 (LDO1), U5.A13 (VCCO_MIO1_501), U5.B16 (VCCO_MIO1_501), U5.D12 (VCCO_MIO1_501), U5.E15 (VCCO_MIO1_501), U5.F8 (VCCPAUX), U5.G8 (VCCPLL), U5.G9 (VCCPAUX), U5.H8 (VCCPAUX), U5.J11 (VCCAUX), U5.K8 (VCCPAUX), U5.L11 (VCCAUX), U5.M8 (VCCPAUX), U5.N9 (VCCAUX), U5.N11 (VCCAUX), U5.P10 (VCCAUX), U5.R9 (VCCAUX), U7.5 (VCCA), U17.8 (REFSEL[0]), U17.11 (REFSEL[1]), U17.14 (REFSEL[2]), U17.28 (VDD18), U17.30 (VDD18), U17.32 (VDDIO)
+VCC_3V3: C1.1, C6.1, C7.1, C43.1, C44.1, C45.1, C52.1, C59.1, C65.1, C69.1, C70.1, C71.1, C74.1, C75.1, C82.1, C83.1, C87.1, C88.1, C89.1, C91.1, C92.1, C93.1, C95.1, C96.1, C97.1, C98.1, C99.1, C100.1, C101.1, C102.1, C103.1, C109.1, C110.1, C185.1, C186.1, C195.1, C196.1, C197.1, C198.1, C201.1, C213.1, D1.2 (A), D2.2 (A), FB2.1, FB4.1, FB8.1, FB9.1, J9.4 (VDD), R32.1, R50.2, R51.2, R53.1, R126.2, R127.1, R128.1, R129.1, R130.2, R132.1, R133.2, R137.1, R139.1, R140.1, R147.2, S2.4, S2.5, S2.6, U2.15 (DCDC4), U3.10 (VIN), U4.12 (VCCIO), U4.24 (VCCIO), U4.39 (VCCD), U4.46 (VCCIO), U5.B6 (VCCO_MIO0_500), U5.C19 (VCCO_35), U5.D7 (VCCO_MIO0_500), U5.F18 (VCCO_35), U5.H14 (VCCO_35), U5.J17 (VCCO_35), U5.K6 (VCCO_0), U5.K20 (VCCO_35), U5.M6 (CFGBVS_0), U5.M16 (VCCO_35), U5.N6 (RSVDVCC3), U5.N19 (VCCO_34), U5.R6 (RSVDVCC2), U5.R15 (VCCO_34), U5.T6 (RSVDVCC1), U5.T8 (VCCO_13), U5.T18 (VCCO_34), U5.U11 (VCCO_13), U5.V14 (VCCO_34), U5.W7 (VCCO_13), U5.W17 (VCCO_34), U5.Y10 (VCCO_13), U5.Y20 (VCCO_34), U7.17 (VCC_B1), U7.21 (VCC_B0), U12.10 (VIN), U13.8 (VCC), U14.C6 (VCCQ), U14.E6 (VCC), U14.F5 (VCC), U14.J10 (VCC), U14.K9 (VCC), U14.M4 (VCCQ), U14.N4 (VCCQ), U14.P3 (VCCQ), U14.P5 (VCCQ), U16.6 (VCC), U17.20 (VDD33), U17.21 (VBAT), Y1.1 (EN), Y1.4 (VDD), Y3.1 (EN), Y3.4 (VDD)
+VCC_DDR_1V5: C5.1, U2.30 (LS1)
+VIN_5V0: C3.1, C9.1, C10.1, C11.1, C33.1, C35.1, C212.1, C219.1, FB1.2, R3.1, U1.1 (EN), U1.7 (VIN), U2.1 (IN_DCDC1), U2.5 (IN_LDO1), U2.9 (AC_DET), U2.12 (IN_DCDC4), U2.27 (IN_BU), U2.36 (IN_BIAS), U2.37 (IN_DCDC3), U2.43 (IN_DCDC2), U4.40 (VREGIN)
+VTT_0V75: C162.1, C184.1, U9.H1 (VREFDQ), U9.M8 (VREFCA), U11.H1 (VREFDQ), U11.M8 (VREFCA)
+VUSB: C199.1, C200.1, FB1.1, J2.A4 (VBUS), J2.A9 (VBUS), J2.B4 (VBUS), J2.B9 (VBUS)
/TC_SWD_CLK: J1.5, U10.24 (PA14)
/TC_SWD_IO: J1.3, U10.23 (PA13)
/TC_USART_RX: J1.2, U10.8 (PA2)
/TC_USART_TX: J1.4, U10.25 (PA15)
/eth-phy/+ETH_1V2: C25.1, C27.1, C28.1, FB6.1, U6.44 (AVDDL_PLL)
/eth-phy/ENET0_MDC: U5.C10 (PS_MIO52_501), U6.36 (MDC)
/eth-phy/ENET0_RXCLK: R30.1, U5.B17 (PS_MIO22_501)
/eth-phy/ENET0_RXCLK_R: R30.2, U6.35 (RXC/PHYAD2)
/eth-phy/ENET0_RXCTL: R29.1, U5.D13 (PS_MIO27_501)
/eth-phy/ENET0_RXCTL_R: R29.2, U6.33 (RX_CTL/CLK125_EN)
/eth-phy/ENET0_RXD0: R22.1, U5.D11 (PS_MIO23_501)
/eth-phy/ENET0_RXD0_R: R13.2, R14.1, R22.2, U6.32 (RXD0/MODE0)
/eth-phy/ENET0_RXD1: R23.1, U5.A16 (PS_MIO24_501)
/eth-phy/ENET0_RXD1_R: R15.2, R16.1, R23.2, U6.31 (RXD1/MODE1)
/eth-phy/ENET0_RXD2: R27.1, U5.F15 (PS_MIO25_501)
/eth-phy/ENET0_RXD2_R: R17.2, R18.1, R27.2, U6.28 (RXD2/MODE2)
/eth-phy/ENET0_RXD3: R28.1, U5.A15 (PS_MIO26_501)
/eth-phy/ENET0_RXD3_R: R19.2, R20.1, R28.2, U6.27 (RXD3/MODE3)
/eth-phy/ENET0_TXCLK: U5.A19 (PS_MIO16_501), U6.24 (TXC)
/eth-phy/ENET0_TXCTL: U5.F14 (PS_MIO21_501), U6.25 (TX_CTL)
/eth-phy/ENET0_TXD0: U5.E14 (PS_MIO17_501), U6.19 (TXD0)
/eth-phy/ENET0_TXD1: U5.B18 (PS_MIO18_501), U6.20 (TXD1)
/eth-phy/ENET0_TXD2: U5.D10 (PS_MIO19_501), U6.21 (TXD2)
/eth-phy/ENET0_TXD3: U5.A17 (PS_MIO20_501), U6.22 (TXD3)
/eth-phy/ETH0_MDIO: R31.2, U5.C11 (PS_MIO53_501), U6.37 (MDIO)
/eth-phy/ETH_LED2: R33.1, U6.15 (LED2/PHYAD1)
/eth-phy/~ENET0_RST: C18.2, R32.2, U5.B13 (PS_MIO50_501), U6.42 (RESET_N)
/ftdi/FTDI_EECLK: R139.2, U4.44 (EECLK), U16.4 (CLK)
/ftdi/FTDI_EECS: R137.2, U4.45 (EECS), U16.5 (CS)
/ftdi/FTDI_EEDATA: R138.2, R140.2, U4.43 (EEDATA), U16.3 (DI)
/ftdi/FTDI_USB_D+: J2.A6 (D1+), J2.B6 (D2+), U4.6 (DM)
/ftdi/FTDI_USB_D-: J2.A7 (D1-), J2.B7 (D2-), U4.7 (DP)
/ftdi/RXLED: R40.1, U4.27 (ACBUS3)
/ftdi/TXLED: R41.1, U4.28 (ACBUS4)
/mcu/ST_I2C1_SCL: R2.2, R26.2, U2.3 (SCL), U10.29 (PB6)
/mcu/ST_I2C1_SDA: R1.2, R25.2, U2.2 (SDA), U10.30 (PB7)
/power/3V3_PGOOD: R5.1, U1.2 (PG)
/power/PMIC_PB: S4.2, S4.4, U2.44 (PB)
/power/PMIC_PGOOD: Q1.1 (G), R136.2, U2.8 (PGOOD)
/power/PMIC_nINT: R11.2, U2.45 (~INT)
/power/PMIC_nPFO: R135.2, U2.10 (~PFO)
/power/PMIC_nWKP: R12.2, U2.40 (~WAKEUP)
/power/PS_VTT_PGOOD: R147.1, U3.9 (PGOOD)
/soc/EMMC_CLK: R131.1, U5.D9 (PS_MIO12_500)
/soc/EMMC_CMD: R133.1, U5.C6 (PS_MIO11_500), U14.M5 (CMD)
/soc/EMMC_D0: R132.2, U5.E9 (PS_MIO10_500), U14.A3 (DAT0)
/soc/EMMC_D1: R129.2, U5.E8 (PS_MIO13_500), U14.A4 (DAT1)
/soc/EMMC_D2: R128.2, U5.C5 (PS_MIO14_500), U14.A5 (DAT2)
/soc/EMMC_D3: R127.2, U5.C8 (PS_MIO15_500), U14.B2 (DAT3)
/soc/FLSH_QSPI_IO0: R58.2, U5.B8 (PS_MIO2_500), U13.5 (SI/IO0)
/soc/FLSH_QSPI_IO1: R56.2, U5.D6 (PS_MIO3_500), U13.2 (SO/IO1)
/soc/FLSH_QSPI_IO2: R57.2, U5.B7 (PS_MIO4_500), U13.3 (~WP/IO2)
/soc/FLSH_QSPI_IO3: R55.2, U5.A6 (PS_MIO5_500), U13.7 (~HOLD/IO3)
/soc/FLSH_QSPI_SCK: R59.2, R134.2, U5.A5 (PS_MIO6_500)
/soc/FLSH_QSPI_nCS: U5.A7 (PS_MIO1_500), U13.1 (~CS)
/soc/SDC_CD: J7.2, J9.9 (CD), R52.2
/soc/SDC_CLK: J9.5 (CLK), U7.19 (CLK_B0)
/soc/SDC_CMD: J9.3 (CMD), U7.20 (CMD_B0)
/soc/SDC_DAT0: J9.7 (DAT0), U7.18 (DAT0_B0)
/soc/SDC_DAT1: J9.8 (DAT1), U7.16 (DAT1_B0)
/soc/SDC_DAT2: J9.1 (DAT2), U7.23 (DAT2_B0)
/soc/SDC_DAT3: J9.2 (DAT3), U7.22 (DAT3_B0)
/soc/SD_CLK: R65.2, U7.9 (CLKA)
/soc/SD_CMD: U5.C17 (PS_MIO41_501), U7.4 (CMDA)
/soc/SD_D0: U5.E12 (PS_MIO42_501), U7.6 (DAT0A)
/soc/SD_D1: U5.A9 (PS_MIO43_501), U7.7 (DAT1A)
/soc/SD_D2: U5.F13 (PS_MIO44_501), U7.1 (DAT2A)
/soc/SD_D3: U5.B15 (PS_MIO45_501), U7.3 (DAT3A)
/soc/SD_SEL: J6.1, R44.1, U7.24 (SEL)
/soc/soc-pl/DDR3_ADDR0: U5.P14 (IO_L6P_T0_34), U8.N3 (A0)
/soc/soc-pl/DDR3_ADDR1: U5.R14 (IO_L6N_T0_VREF_34), U8.P7 (A1)
/soc/soc-pl/DDR3_ADDR2: U5.Y16 (IO_L7P_T1_34), U8.P3 (A2)
/soc/soc-pl/DDR3_ADDR3: U5.Y17 (IO_L7N_T1_34), U8.N2 (A3)
/soc/soc-pl/DDR3_ADDR4: U5.W14 (IO_L8P_T1_34), U8.P8 (A4)
/soc/soc-pl/DDR3_ADDR5: U5.Y14 (IO_L8N_T1_34), U8.P2 (A5)
/soc/soc-pl/DDR3_ADDR6: U5.T16 (IO_L9P_T1_DQS_34), U8.R8 (A6)
/soc/soc-pl/DDR3_ADDR7: U5.U17 (IO_L9N_T1_DQS_34), U8.R2 (A7)
/soc/soc-pl/DDR3_ADDR8: U5.V15 (IO_L10P_T1_34), U8.T8 (A8)
/soc/soc-pl/DDR3_ADDR9: U5.W15 (IO_L10N_T1_34), U8.R3 (A9)
/soc/soc-pl/DDR3_ADDR10: U5.U14 (IO_L11P_T1_SRCC_34), U8.L7 (A10/AP)
/soc/soc-pl/DDR3_ADDR11: U5.U15 (IO_L11N_T1_SRCC_34), U8.R7 (A11)
/soc/soc-pl/DDR3_ADDR12: U5.U18 (IO_L12P_T1_MRCC_34), U8.N7 (A12/~BC)
/soc/soc-pl/DDR3_ADDR13: U5.U19 (IO_L12N_T1_MRCC_34), U8.T3 (A13)
/soc/soc-pl/DDR3_ADDR14: U5.N18 (IO_L13P_T2_MRCC_34), U8.T7 (A14)
/soc/soc-pl/DDR3_BA0: U5.U20 (IO_L15N_T2_DQS_34), U8.M2 (BA0)
/soc/soc-pl/DDR3_BA1: U5.N20 (IO_L14P_T2_SRCC_34), U8.N8 (BA1)
/soc/soc-pl/DDR3_BA2: U5.P20 (IO_L14N_T2_SRCC_34), U8.M3 (BA2)
/soc/soc-pl/DDR3_CK+: U5.V20 (IO_L16P_T2_34), U8.J7 (CK)
/soc/soc-pl/DDR3_CK-: U5.W20 (IO_L16N_T2_34), U8.K7 (~CK)
/soc/soc-pl/DDR3_CKE: U5.R16 (IO_L19P_T3_34), U8.K9 (CKE)
/soc/soc-pl/DDR3_D0: U5.R19 (IO_0_34), U8.E3 (DQ0)
/soc/soc-pl/DDR3_D1: U5.T11 (IO_L1P_T0_34), U8.F7 (DQ1)
/soc/soc-pl/DDR3_D2: U5.T10 (IO_L1N_T0_34), U8.F2 (DQ2)
/soc/soc-pl/DDR3_D3: U5.T12 (IO_L2P_T0_34), U8.F8 (DQ3)
/soc/soc-pl/DDR3_D4: U5.U12 (IO_L2N_T0_34), U8.H3 (DQ4)
/soc/soc-pl/DDR3_D5: U5.P19 (IO_L13N_T2_MRCC_34), U8.H8 (DQ5)
/soc/soc-pl/DDR3_D6: U5.T20 (IO_L15P_T2_DQS_34), U8.G2 (DQ6)
/soc/soc-pl/DDR3_D7: U5.R17 (IO_L19N_T3_VREF_34), U8.H7 (DQ7)
/soc/soc-pl/DDR3_D8: U5.V17 (IO_L21P_T3_DQS_34), U8.D7 (DQ8)
/soc/soc-pl/DDR3_D9: U5.V18 (IO_L21N_T3_DQS_34), U8.C3 (DQ9)
/soc/soc-pl/DDR3_D10: U5.W18 (IO_L22P_T3_34), U8.C8 (DQ10)
/soc/soc-pl/DDR3_D11: U5.W19 (IO_L22N_T3_34), U8.C2 (DQ11)
/soc/soc-pl/DDR3_D12: U5.N17 (IO_L23P_T3_34), U8.A7 (DQ12)
/soc/soc-pl/DDR3_D13: U5.P18 (IO_L23N_T3_34), U8.A2 (DQ13)
/soc/soc-pl/DDR3_D14: U5.P15 (IO_L24P_T3_34), U8.B8 (DQ14)
/soc/soc-pl/DDR3_D15: U5.P16 (IO_L24N_T3_34), U8.A3 (DQ15)
/soc/soc-pl/DDR3_DM0: U5.T14 (IO_L5P_T0_34), U8.E7 (LDM)
/soc/soc-pl/DDR3_DM1: U5.T15 (IO_L5N_T0_34), U8.D3 (UDM)
/soc/soc-pl/DDR3_DQS0+: U5.U13 (IO_L3P_T0_DQS_PUDC_B_34), U8.F3 (LDQS)
/soc/soc-pl/DDR3_DQS0-: U5.V13 (IO_L3N_T0_DQS_34), U8.G3 (~LDQS)
/soc/soc-pl/DDR3_DQS1+: U5.V12 (IO_L4P_T0_34), U8.C7 (UDQS)
/soc/soc-pl/DDR3_DQS1-: U5.W13 (IO_L4N_T0_34), U8.B7 (~UDQS)
/soc/soc-pl/DDR3_ODT0: U5.R18 (IO_L20N_T3_34), U8.K1 (ODT)
/soc/soc-pl/DDR3_nCAS: U5.Y19 (IO_L17N_T2_34), U8.K3 (~CAS)
/soc/soc-pl/DDR3_nCS: U5.T17 (IO_L20P_T3_34), U8.L2 (~CS)
/soc/soc-pl/DDR3_nRAS: U5.Y18 (IO_L17P_T2_34), U8.J3 (~RAS)
/soc/soc-pl/DDR3_nRST: U5.W16 (IO_L18N_T2_34), U8.T2 (~RESET)
/soc/soc-pl/DDR3_nWE: U5.V16 (IO_L18P_T2_34), U8.L3 (~WE)
/soc/soc-pl/ram-pl/PL_VTT_PGOOD: R126.1, U12.9 (PGOOD)
/soc/soc-ps/JTAG_TCK: D3.4 (IO3), D3.7 (NC), R47.1, TP3.1
/soc/soc-ps/JTAG_TCK_R: R36.2, R47.2, U5.F9 (TCK_0)
/soc/soc-ps/JTAG_TDI: D3.2 (IO2), D3.9 (NC), R46.1, TP2.1
/soc/soc-ps/JTAG_TDI_R: R38.2, R46.2, U5.G6 (TDI_0)
/soc/soc-ps/JTAG_TDO: D3.1 (IO1), D3.10 (NC), R45.1, TP1.1
/soc/soc-ps/JTAG_TDO_R: R45.2, U4.15 (ADBUS2), U5.F6 (TDO_0)
/soc/soc-ps/JTAG_TMS: D3.5 (IO4), D3.6 (NC), R48.1, TP4.1
/soc/soc-ps/JTAG_TMS_R: R48.2, U4.16 (ADBUS3), U5.J6 (TMS_0)
/soc/soc-ps/MIO7: R54.2, U5.D8 (PS_MIO7_500)
/soc/soc-ps/MIO8: R53.2, U5.D5 (PS_MIO8_500)
/soc/soc-ps/PS_CLK_50M: U5.E7 (PS_CLK_500), Y1.3 (OUT)
/soc/soc-ps/RGMII_VREF: R66.2, R67.1, U5.E11 (PS_MIO_VREF_501)
/soc/soc-ps/SD0_CD: J7.1, J8.2, U5.B12 (PS_MIO48_501)
/soc/soc-ps/USB0_CLK: R143.1, U5.A11 (PS_MIO36_501), U17.26 (REFCLK)
/soc/soc-ps/USB0_DATA0: U5.A14 (PS_MIO32_501), U17.3 (DATA[0])
/soc/soc-ps/USB0_DATA1: U5.D15 (PS_MIO33_501), U17.4 (DATA[1])
/soc/soc-ps/USB0_DATA2: U5.A12 (PS_MIO34_501), U17.5 (DATA[2])
/soc/soc-ps/USB0_DATA3: U5.F12 (PS_MIO35_501), U17.6 (DATA[3])
/soc/soc-ps/USB0_DATA4: U5.C16 (PS_MIO28_501), U17.7 (DATA[4])
/soc/soc-ps/USB0_DATA5: U5.A10 (PS_MIO37_501), U17.9 (DATA[5])
/soc/soc-ps/USB0_DATA6: U5.E13 (PS_MIO38_501), U17.10 (DATA[6])
/soc/soc-ps/USB0_DATA7: U5.C18 (PS_MIO39_501), U17.13 (DATA[7])
/soc/soc-ps/USB0_DIR: U5.C13 (PS_MIO29_501), U17.31 (DIR)
/soc/soc-ps/USB0_NXT: U5.E16 (PS_MIO31_501), U17.2 (NXT)
/soc/soc-ps/USB0_STP: U5.C15 (PS_MIO30_501), U17.29 (STP)
/soc/soc-ps/VADC+: C106.1, C107.1, C108.1, FB10.2, R42.2, U5.J9 (VCCADC_0), U5.K9 (VP_0)
/soc/soc-ps/VADC-: C106.2, C107.2, C108.2, FB11.2, R43.2, U5.J10 (GNDADC_0), U5.L10 (VN_0)
/soc/soc-ps/ZYNQ_DONE_0: D4.2 (A), U5.R11 (DONE_0)
/soc/soc-ps/ZYNQ_NRST: R63.2, R64.1, U5.B10 (PS_SRST_B_501)
/soc/soc-ps/~USB_RST: R142.2, U5.B9 (PS_MIO51_501), U17.27 (~RESET)
/soc/soc-ram/DDR3_A0: R109.2, U5.N2 (PS_DDR_A0_502)
/soc/soc-ram/DDR3_A1: R108.2, U5.K2 (PS_DDR_A1_502)
/soc/soc-ram/DDR3_A2: R107.2, U5.M3 (PS_DDR_A2_502)
/soc/soc-ram/DDR3_A3: R106.2, U5.K3 (PS_DDR_A3_502)
/soc/soc-ram/DDR3_A4: R105.2, U5.M4 (PS_DDR_A4_502)
/soc/soc-ram/DDR3_A5: R104.2, U5.L1 (PS_DDR_A5_502)
/soc/soc-ram/DDR3_A6: R103.2, U5.L4 (PS_DDR_A6_502)
/soc/soc-ram/DDR3_A7: R102.2, U5.K4 (PS_DDR_A7_502)
/soc/soc-ram/DDR3_A8: R101.2, U5.K1 (PS_DDR_A8_502)
/soc/soc-ram/DDR3_A9: R100.2, U5.J4 (PS_DDR_A9_502)
/soc/soc-ram/DDR3_A10: R99.2, U5.F5 (PS_DDR_A10_502)
/soc/soc-ram/DDR3_A11: R98.2, U5.G4 (PS_DDR_A11_502)
/soc/soc-ram/DDR3_A12: R97.2, U5.E4 (PS_DDR_A12_502)
/soc/soc-ram/DDR3_A13: R96.2, U5.D4 (PS_DDR_A13_502)
/soc/soc-ram/DDR3_A14: R95.2, U5.F4 (PS_DDR_A14_502)
/soc/soc-ram/DDR3_ADDR0: R77.2, R109.1, U9.N3 (A0), U11.N3 (A0)
/soc/soc-ram/DDR3_ADDR1: R78.2, R108.1, U9.P7 (A1), U11.P7 (A1)
/soc/soc-ram/DDR3_ADDR2: R79.2, R107.1, U9.P3 (A2), U11.P3 (A2)
/soc/soc-ram/DDR3_ADDR3: R80.2, R106.1, U9.N2 (A3), U11.N2 (A3)
/soc/soc-ram/DDR3_ADDR4: R81.2, R105.1, U9.P8 (A4), U11.P8 (A4)
/soc/soc-ram/DDR3_ADDR5: R82.2, R104.1, U9.P2 (A5), U11.P2 (A5)
/soc/soc-ram/DDR3_ADDR6: R83.2, R103.1, U9.R8 (A6), U11.R8 (A6)
/soc/soc-ram/DDR3_ADDR7: R84.2, R102.1, U9.R2 (A7), U11.R2 (A7)
/soc/soc-ram/DDR3_ADDR8: R85.2, R101.1, U9.T8 (A8), U11.T8 (A8)
/soc/soc-ram/DDR3_ADDR9: R86.2, R100.1, U9.R3 (A9), U11.R3 (A9)
/soc/soc-ram/DDR3_ADDR10: R87.2, R99.1, U9.L7 (A10/AP), U11.L7 (A10/AP)
/soc/soc-ram/DDR3_ADDR11: R88.2, R98.1, U9.R7 (A11), U11.R7 (A11)
/soc/soc-ram/DDR3_ADDR12: R89.2, R97.1, U9.N7 (A12/~BC), U11.N7 (A12/~BC)
/soc/soc-ram/DDR3_ADDR13: R90.2, R96.1, U9.T3 (A13), U11.T3 (A13)
/soc/soc-ram/DDR3_ADDR14: R91.2, R95.1, U9.T7 (A14), U11.T7 (A14)
/soc/soc-ram/DDR3_BA0: R76.2, R112.1, U9.M2 (BA0), U11.M2 (BA0)
/soc/soc-ram/DDR3_BA1: R75.2, R111.1, U9.N8 (BA1), U11.N8 (BA1)
/soc/soc-ram/DDR3_BA2: R74.2, R110.1, U9.M3 (BA2), U11.M3 (BA2)
/soc/soc-ram/DDR3_CK+: R119.1, U5.L2 (PS_DDR_CKP_502), U9.J7 (CK), U11.J7 (CK)
/soc/soc-ram/DDR3_CK-: R119.2, U5.M2 (PS_DDR_CKN_502), U9.K7 (~CK), U11.K7 (~CK)
/soc/soc-ram/DDR3_CKE: R73.2, R93.2, R117.1, U9.K9 (CKE), U11.K9 (CKE)
/soc/soc-ram/DDR3_D0: U5.B3 (PS_DDR_DQ1_502), U11.E3 (DQ0)
/soc/soc-ram/DDR3_D1: U5.D1 (PS_DDR_DQ5_502), U11.F7 (DQ1)
/soc/soc-ram/DDR3_D2: U5.A2 (PS_DDR_DQ2_502), U11.F2 (DQ2)
/soc/soc-ram/DDR3_D3: U5.E1 (PS_DDR_DQ7_502), U11.F8 (DQ3)
/soc/soc-ram/DDR3_D4: U5.C3 (PS_DDR_DQ0_502), U11.H3 (DQ4)
/soc/soc-ram/DDR3_D5: U5.C1 (PS_DDR_DQ6_502), U11.H8 (DQ5)
/soc/soc-ram/DDR3_D6: U5.A4 (PS_DDR_DQ3_502), U11.G2 (DQ6)
/soc/soc-ram/DDR3_D7: U5.D3 (PS_DDR_DQ4_502), U11.H7 (DQ7)
/soc/soc-ram/DDR3_D8: U5.H2 (PS_DDR_DQ13_502), U11.D7 (DQ8)
/soc/soc-ram/DDR3_D9: U5.H3 (PS_DDR_DQ11_502), U11.C3 (DQ9)
/soc/soc-ram/DDR3_D10: U5.J1 (PS_DDR_DQ15_502), U11.C8 (DQ10)
/soc/soc-ram/DDR3_D11: U5.G3 (PS_DDR_DQ10_502), U11.C2 (DQ11)
/soc/soc-ram/DDR3_D12: U5.J3 (PS_DDR_DQ12_502), U11.A7 (DQ12)
/soc/soc-ram/DDR3_D13: U5.E3 (PS_DDR_DQ9_502), U11.A2 (DQ13)
/soc/soc-ram/DDR3_D14: U5.H1 (PS_DDR_DQ14_502), U11.B8 (DQ14)
/soc/soc-ram/DDR3_D15: U5.E2 (PS_DDR_DQ8_502), U11.A3 (DQ15)
/soc/soc-ram/DDR3_D16: U5.R1 (PS_DDR_DQ19_502), U9.E3 (DQ0)
/soc/soc-ram/DDR3_D17: U5.U2 (PS_DDR_DQ22_502), U9.F7 (DQ1)
/soc/soc-ram/DDR3_D18: U5.P1 (PS_DDR_DQ16_502), U9.F2 (DQ2)
/soc/soc-ram/DDR3_D19: U5.U3 (PS_DDR_DQ23_502), U9.F8 (DQ3)
/soc/soc-ram/DDR3_D20: U5.P3 (PS_DDR_DQ17_502), U9.H3 (DQ4)
/soc/soc-ram/DDR3_D21: U5.U4 (PS_DDR_DQ21_502), U9.H8 (DQ5)
/soc/soc-ram/DDR3_D22: U5.R3 (PS_DDR_DQ18_502), U9.G2 (DQ6)
/soc/soc-ram/DDR3_D23: U5.T4 (PS_DDR_DQ20_502), U9.H7 (DQ7)
/soc/soc-ram/DDR3_D24: U5.Y3 (PS_DDR_DQ25_502), U9.D7 (DQ8)
/soc/soc-ram/DDR3_D25: U5.V3 (PS_DDR_DQ31_502), U9.C3 (DQ9)
/soc/soc-ram/DDR3_D26: U5.Y4 (PS_DDR_DQ27_502), U9.C8 (DQ10)
/soc/soc-ram/DDR3_D27: U5.W1 (PS_DDR_DQ26_502), U9.C2 (DQ11)
/soc/soc-ram/DDR3_D28: U5.W3 (PS_DDR_DQ29_502), U9.A7 (DQ12)
/soc/soc-ram/DDR3_D29: U5.V1 (PS_DDR_DQ24_502), U9.A2 (DQ13)
/soc/soc-ram/DDR3_D30: U5.Y2 (PS_DDR_DQ28_502), U9.B8 (DQ14)
/soc/soc-ram/DDR3_D31: U5.V2 (PS_DDR_DQ30_502), U9.A3 (DQ15)
/soc/soc-ram/DDR3_DM0: U5.A1 (PS_DDR_DM0_502), U11.E7 (LDM)
/soc/soc-ram/DDR3_DM1: U5.F1 (PS_DDR_DM1_502), U11.D3 (UDM)
/soc/soc-ram/DDR3_DM2: U5.T1 (PS_DDR_DM2_502), U9.E7 (LDM)
/soc/soc-ram/DDR3_DM3: U5.Y1 (PS_DDR_DM3_502), U9.D3 (UDM)
/soc/soc-ram/DDR3_DQS0+: U5.C2 (PS_DDR_DQS_P0_502), U11.F3 (LDQS)
/soc/soc-ram/DDR3_DQS0-: U5.B2 (PS_DDR_DQS_N0_502), U11.G3 (~LDQS)
/soc/soc-ram/DDR3_DQS1+: U5.G2 (PS_DDR_DQS_P1_502), U11.C7 (UDQS)
/soc/soc-ram/DDR3_DQS1-: U5.F2 (PS_DDR_DQS_N1_502), U11.B7 (~UDQS)
/soc/soc-ram/DDR3_DQS2+: U5.R2 (PS_DDR_DQS_P2_502), U9.F3 (LDQS)
/soc/soc-ram/DDR3_DQS2-: U5.T2 (PS_DDR_DQS_N2_502), U9.G3 (~LDQS)
/soc/soc-ram/DDR3_DQS3+: U5.W5 (PS_DDR_DQS_P3_502), U9.C7 (UDQS)
/soc/soc-ram/DDR3_DQS3-: U5.W4 (PS_DDR_DQS_N3_502), U9.B7 (~UDQS)
/soc/soc-ram/DDR3_ODT0: R68.2, R118.1, U9.K1 (ODT), U11.K1 (ODT)
/soc/soc-ram/DDR3_RST: R92.1, U5.B4 (PS_DDR_DRST_B_502)
/soc/soc-ram/DDR3_nCAS: R70.2, R114.1, U9.K3 (~CAS), U11.K3 (~CAS)
/soc/soc-ram/DDR3_nCS: R72.2, R115.1, U9.L2 (~CS), U11.L2 (~CS)
/soc/soc-ram/DDR3_nRAS: R71.2, R113.1, U9.J3 (~RAS), U11.J3 (~RAS)
/soc/soc-ram/DDR3_nRST: U9.T2 (~RESET), U11.T2 (~RESET)
/soc/soc-ram/DDR3_nWE: R69.2, R116.1, U9.L3 (~WE), U11.L3 (~WE)
/soc/~EMMC_RST: R130.1, U14.K5 (~RST)
/~TC_SWD_RST: J1.7, R24.1, U10.4 (NRST)
GND: C1.2, C2.2, C3.2, C4.2, C5.2, C6.2, C7.2, C8.2, C9.2, C10.2, C11.2, C13.2, C14.2, C15.2, C16.2, C17.2, C18.1, C19.2, C20.2, C21.2, C22.2, C23.2, C24.2, C25.2, C26.2, C27.2, C28.2, C29.2, C30.2, C31.2, C32.2, C33.2, C34.2, C35.2, C36.2, C37.2, C38.2, C39.2, C40.2, C41.2, C42.2, C43.2, C44.2, C45.2, C46.2, C47.2, C48.2, C49.2, C50.2, C51.2, C52.2, C53.2, C54.2, C55.2, C56.2, C57.2, C58.2, C59.2, C60.2, C61.2, C62.2, C63.2, C64.2, C65.2, C66.2, C67.2, C68.2, C69.2, C70.2, C71.2, C72.2, C73.2, C74.2, C75.2, C76.2, C77.2, C78.2, C79.2, C80.2, C81.2, C82.2, C83.2, C84.2, C85.2, C86.2, C87.2, C88.2, C89.2, C90.2, C91.2, C92.2, C93.2, C94.2, C95.2, C96.2, C97.2, C98.2, C99.2, C100.2, C101.2, C102.2, C103.2, C104.2, C105.2, C109.2, C110.2, C111.2, C112.2, C113.2, C114.2, C115.2, C116.2, C117.2, C118.2, C119.2, C120.2, C121.2, C122.2, C123.2, C124.2, C125.2, C126.2, C127.2, C128.2, C129.2, C130.2, C131.2, C132.2, C133.2, C134.2, C135.2, C136.2, C137.2, C138.2, C139.2, C140.2, C141.2, C142.2, C143.2, C144.2, C145.2, C146.2, C147.2, C148.2, C149.2, C150.2, C151.2, C152.2, C153.2, C154.2, C155.2, C156.2, C157.2, C158.2, C159.2, C160.2, C161.2, C162.2, C163.2, C164.2, C165.2, C166.2, C167.2, C168.2, C169.2, C170.2, C171.2, C172.2, C173.2, C174.2, C175.2, C176.2, C177.2, C178.2, C179.2, C180.2, C181.2, C182.2, C183.2, C184.2, C185.2, C186.2, C187.2, C188.2, C189.2, C190.2, C191.2, C192.2, C193.2, C194.2, C195.2, C196.2, C197.2, C198.2, C201.2, C202.2, C203.2, C204.2, C205.2, C206.2, C207.2, C208.2, C209.2, C210.2, C211.2, C212.2, C213.2, C214.2, C215.2, C216.2, C217.2, C218.2, C219.2, C220.2, C221.2, C222.2, C223.2, C224.2, C225.2, D3.3 (GND), D3.8 (GND), FB11.1, FB12.2, H1.1, H2.1, J1.9, J9.6 (VSS), J9.S1, J9.S2, J9.S3, J9.S4, R4.2, R8.2, R10.2, R14.2, R16.2, R18.2, R20.2, R24.2, R34.2, R35.2, R44.2, R49.1, R54.1, R58.1, R59.1, R60.2, R61.2, R62.2, R67.2, R92.2, R94.2, R121.2, R122.2, R123.2, R125.2, R141.2, R146.2, S1.2, S1.4, S3.2, S3.4, S4.1, S4.3, U1.5 (GND), U2.20 (L5), U2.21 (FB5), U2.22 (FB6), U2.23 (L6), U2.24 (SYS_BU), U2.49 (EP), U3.4 (PGND), U3.8 (GND), U3.11 (EP), U4.4 (AGND), U4.9 (AGND), U4.10 (GND), U4.11 (GND), U4.22 (GND), U4.23 (GND), U4.35 (GND), U4.36 (GND), U4.41 (AGND), U4.42 (TEST), U4.47 (GND), U4.48 (GND), U5.A8 (GND), U5.A18 (GND), U5.B1 (GND), U5.B11 (GND), U5.C4 (GND), U5.C9 (GND), U5.C14 (GND), U5.D17 (GND), U5.E10 (GND), U5.E20 (GND), U5.F3 (GND), U5.F7 (GND), U5.F10 (RSVDGND), U5.G10 (GND), U5.G12 (GND), U5.G16 (GND), U5.H7 (GND), U5.H9 (GND), U5.H11 (GND), U5.H13 (GND), U5.H19 (GND), U5.J2 (GND), U5.J8 (GND), U5.J12 (GND), U5.K5 (GND), U5.K7 (GND), U5.K11 (GND), U5.K13 (GND), U5.K15 (GND), U5.L8 (GND), U5.L12 (GND), U5.L18 (GND), U5.M1 (GND), U5.M7 (GND), U5.M9 (DXP_0), U5.M10 (DXN_0), U5.M11 (GND), U5.M13 (GND), U5.N4 (GND), U5.N8 (GND), U5.N10 (GND), U5.N12 (GND), U5.N14 (GND), U5.P7 (GND), U5.P9 (GND), U5.P11 (GND), U5.P13 (GND), U5.P17 (GND), U5.R8 (GND), U5.R12 (GND), U5.R20 (GND), U5.T3 (GND), U5.T7 (GND), U5.T13 (GND), U5.U6 (GND), U5.U16 (GND), U5.V9 (GND), U5.V19 (GND), U5.W2 (GND), U5.W12 (GND), U5.Y5 (GND), U5.Y15 (GND), U6.29 (VSS), U6.45 (XO), U6.49 (EP), U7.2 (GND), U7.11 (GND), U7.25 (EP), U8.A9 (VSS), U8.B1 (VSSQ), U8.B3 (VSS), U8.B9 (VSSQ), U8.D1 (VSSQ), U8.D8 (VSSQ), U8.E1 (VSS), U8.E2 (VSSQ), U8.E8 (VSSQ), U8.F9 (VSSQ), U8.G1 (VSSQ), U8.G8 (VSS), U8.G9 (VSSQ), U8.J2 (VSS), U8.J8 (VSS), U8.M1 (VSS), U8.M9 (VSS), U8.P1 (VSS), U8.P9 (VSS), U8.T1 (VSS), U8.T9 (VSS), U9.A9 (VSS), U9.B1 (VSSQ), U9.B3 (VSS), U9.B9 (VSSQ), U9.D1 (VSSQ), U9.D8 (VSSQ), U9.E1 (VSS), U9.E2 (VSSQ), U9.E8 (VSSQ), U9.F9 (VSSQ), U9.G1 (VSSQ), U9.G8 (VSS), U9.G9 (VSSQ), U9.J2 (VSS), U9.J8 (VSS), U9.M1 (VSS), U9.M9 (VSS), U9.P1 (VSS), U9.P9 (VSS), U9.T1 (VSS), U9.T9 (VSS), U10.16 (VSS), U10.32 (VSS), U10.33 (VSS), U11.A9 (VSS), U11.B1 (VSSQ), U11.B3 (VSS), U11.B9 (VSSQ), U11.D1 (VSSQ), U11.D8 (VSSQ), U11.E1 (VSS), U11.E2 (VSSQ), U11.E8 (VSSQ), U11.F9 (VSSQ), U11.G1 (VSSQ), U11.G8 (VSS), U11.G9 (VSSQ), U11.J2 (VSS), U11.J8 (VSS), U11.M1 (VSS), U11.M9 (VSS), U11.P1 (VSS), U11.P9 (VSS), U11.T1 (VSS), U11.T9 (VSS), U12.4 (PGND), U12.8 (GND), U12.11 (EP), U13.4 (VSS), U13.9 (EP), U14.A6 (VSS), U14.C4 (VSSQ), U14.E7 (VSS), U14.G5 (VSS), U14.H10 (VSS), U14.J5 (VSS), U14.K8 (VSS), U14.N2 (VSSQ), U14.N5 (VCCQ), U14.P4 (VSSQ), U14.P6 (VSSQ), U16.2 (VSS), Y1.2 (GND), Y2.2, Y2.4, Y3.2 (GND), Y4.2, Y4.4
GND_USB: C199.2, C200.2, FB12.1, J2.A1 (GND), J2.A12 (GND), J2.B1 (GND), J2.B12 (GND), J2.SH1 (SHIELD1), J2.SH2 (SHIELD2), R6.2, R7.2
unnamed: C210.1, R143.2, R145.1, Y4.3
unnamed: C211.1, R144.2, R145.2, Y4.1
unnamed: D1.1 (K), R40.2
unnamed: D2.1 (K), R41.2
unnamed: D4.1 (K), R49.2
unnamed: D5.2 (A), Q1.2 (S)
unnamed: D5.1 (K), R146.1
unnamed: J2.A5 (CC1), R6.1
unnamed: J2.B5 (CC2), R7.1
unnamed: R55.1, R60.1, S2.1
unnamed: R56.1, R61.1, S2.2
unnamed: R57.1, R62.1, S2.3
unnamed: R64.2, S3.1, S3.3
unnamed: L2.1, U1.6 (SW)
unnamed: R8.1, U2.17 (DC34_SEL)
unnamed: C15.1, U2.35 (INT_LDO)
unnamed: L4.2, U2.48 (L1)
unnamed: L5.2, U2.42 (L2)
unnamed: L3.2, U2.38 (L3)
unnamed: L1.2, U2.13 (L4A)
unnamed: L1.1, U2.14 (L4B)
unnamed: C13.1, R3.2, R4.1, U2.16 (PFI)
unnamed: C214.1, R9.2, R10.1, U3.1 (REFIN)
unnamed: R36.1, R37.1, U4.13 (ADBUS0)
unnamed: R38.1, R39.1, U4.14 (ADBUS1)
unnamed: R35.1, U4.5 (REF)
unnamed: C38.1, U4.37 (VCCA)
unnamed: C36.1, U4.38 (VCCCORE)
unnamed: C40.1, C42.1, FB9.2, U4.3 (VPHY)
unnamed: C39.1, C41.1, FB8.2, U4.8 (VPLL)
unnamed: C34.1, U4.1 (XCSI), Y2.3
unnamed: C37.1, U4.2 (XCSO), Y2.1
unnamed: R51.1, U5.R10 (INIT_B_0)
unnamed: R50.1, S1.1, S1.3, U5.L6 (PROGRAM_B_0)
unnamed: R65.1, U5.D14 (PS_MIO40_501)
unnamed: R112.2, U5.L5 (PS_DDR_BA0_502)
unnamed: R111.2, U5.R4 (PS_DDR_BA1_502)
unnamed: R110.2, U5.J5 (PS_DDR_BA2_502)
unnamed: R114.2, U5.P5 (PS_DDR_CAS_B_502)
unnamed: R117.2, U5.N3 (PS_DDR_CKE_502)
unnamed: R115.2, U5.N1 (PS_DDR_CS_B_502)
unnamed: R113.2, U5.P4 (PS_DDR_RAS_B_502)
unnamed: R116.2, U5.M5 (PS_DDR_WE_B_502)
unnamed: R34.1, U6.48 (ISET)
unnamed: R21.2, U6.46 (XI)
unnamed: R121.1, U8.L8 (ZQ)
unnamed: R123.1, U9.L8 (ZQ)
unnamed: R122.1, U11.L8 (ZQ)
unnamed: C187.1, R124.2, R125.1, U12.1 (REFIN)
unnamed: R134.1, U13.6 (SCK)
unnamed: R131.2, U14.M6 (CLK)
unnamed: U14.A11 (DVDD), U14.G14 (DVDD), U14.M2 (DVDD), U14.P11 (DVDD)
unnamed: U14.A8 (DVDDQ), U14.B13 (DVDDQ), U14.C14 (DVDDQ), U14.G3 (DVDDQ), U14.G13 (DVDDQ), U14.H1 (DVDDQ), U14.H13 (DVDDQ), U14.M14 (DVDDQ), U14.N13 (DVDDQ), U14.P7 (DVDDQ), U14.P8 (DVDDQ)
unnamed: U14.A10 (DVSS), U14.C1 (DVSS), U14.H14 (DVSS), U14.K2 (DVSS), U14.M1 (DVSS)
unnamed: U14.A9 (DVSSQ), U14.A12 (DVSSQ), U14.D14 (DVSSQ), U14.F14 (DVSSQ), U14.L14 (DVSSQ), U14.N6 (DVSSQ), U14.P9 (DVSSQ), U14.P12 (DVSSQ)
unnamed: U14.A1 (NC), U14.A2 (NC), U14.A13 (NC), U14.A14 (NC), U14.B1 (NC), U14.B7 (NC), U14.B8 (NC), U14.B9 (NC), U14.B10 (NC), U14.B11 (NC), U14.B12 (NC), U14.B14 (NC), U14.C3 (NC), U14.C5 (NC), U14.C7 (NC), U14.C8 (NC), U14.C9 (NC), U14.C10 (NC), U14.C11 (NC), U14.C12 (NC), U14.C13 (NC), U14.D1 (NC), U14.D2 (NC), U14.D3 (NC), U14.D4 (NC), U14.D12 (NC), U14.D13 (NC), U14.E1 (NC), U14.E2 (NC), U14.E3 (NC), U14.E12 (NC), U14.E13 (NC), U14.E14 (NC), U14.F2 (NC), U14.F3 (NC), U14.F12 (NC), U14.F13 (NC), U14.G1 (NC), U14.G2 (NC), U14.G12 (NC), U14.H2 (NC), U14.H3 (NC), U14.H12 (NC), U14.J1 (NC), U14.J2 (NC), U14.J3 (NC), U14.J12 (NC), U14.J13 (NC), U14.K1 (NC), U14.K3 (NC), U14.K12 (NC), U14.K13 (NC), U14.K14 (NC), U14.L1 (NC), U14.L2 (NC), U14.L3 (NC), U14.L12 (NC), U14.L13 (NC), U14.M3 (NC), U14.M7 (NC), U14.M8 (NC), U14.M9 (NC), U14.M10 (NC), U14.M11 (NC), U14.M12 (NC), U14.M13 (NC), U14.N1 (NC), U14.N3 (NC), U14.N7 (NC), U14.N8 (NC), U14.N9 (NC), U14.N11 (NC), U14.N12 (NC), U14.N14 (NC), U14.P1 (NC), U14.P2 (NC), U14.P13 (NC), U14.P14 (NC)
unnamed: U14.A7 (RFU), U14.E5 (RFU), U14.K6 (RFU), U14.K7 (RFU)
unnamed: C194.1, U14.C2 (VDDI)
unnamed: U14.E8 (VSF), U14.E9 (VSF), U14.E10 (VSF), U14.F10 (VSF), U14.G10 (VSF), U14.K10 (VSF), U14.P10 (VSF)
unnamed: R138.1, U16.1 (DO)
unnamed: R141.1, U17.24 (RBIAS)
unnamed: R144.1, U17.25 (XO)
unnamed: R21.1, Y3.3 (OUT)
