Bonafide116/rfsom01/(commit log)

2025-05-31 initial commit; significant progress;
    [ddr.kicad_sch, emmc.kicad_sch, eth-phy.kicad_sch, mcu.kicad_sch, mezzanine.kicad_sch, power.kicad_sch, ram.kicad_sch, rfsom-01.kicad_pcb]
2025-06-02 ddr progress; added more conns;
    [ddr.kicad_sch, emmc.kicad_sch, eth-phy.kicad_sch, mcu.kicad_sch, mezzanine.kicad_sch, power.kicad_sch, ram.kicad_sch, rfsom-01.kicad_pcb]
2025-06-09 ps progress; added ftdi; mezz pinout pedinging;
    [emmc.kicad_sch, eth-phy.kicad_sch, ftdi.kicad_sch, mezzanine.kicad_sch, power.kicad_sch, ram.kicad_sch, rfsom-01.kicad_sch, soc-ddr.kicad_sch]
2025-06-28 some ddr routing progress; layerstack per pcbway standard options, review reqd; commit prior to ddr split;
    [eth-phy.kicad_sch, ftdi.kicad_sch, mcu.kicad_sch, mezzanine.kicad_sch, power.kicad_sch, ram.kicad_sch, rfsom-01.kicad_pcb, rfsom-01.kicad_sch]
2025-07-07 added starage, usb sch; more design progress in sch;
    [emmc.kicad_sch, eth-phy.kicad_sch, ftdi.kicad_sch, mezzanine.kicad_sch, power.kicad_sch, ram.kicad_sch, rfsom-01.kicad_pcb, rfsom-01.kicad_sch]
2025-07-27 routing changes; added mezzanine; added pl ram;
    [eth-phy.kicad_sch, ftdi.kicad_sch, mezzanine.kicad_sch, power.kicad_sch, ram-pl.kicad_sch, ram.kicad_sch, rfsom-01.kicad_pcb, rfsom-01.kicad_sch]
2025-08-06 updated sch pdf; routign progress;
    [eth-phy.kicad_sch, mezzanine.kicad_sch, power.kicad_sch, ram-pl.kicad_sch, rfsom-01.kicad_pcb, soc-pl.kicad_sch, soc-power.kicad_sch]
2025-09-08 replaced pmic;
    [eth-phy.kicad_sch, ftdi.kicad_sch, mcu.kicad_sch, power.kicad_sch, rfsom-01.kicad_pcb, soc-ddr.kicad_sch, soc-power.kicad_sch, storage.kicad_sch]
2026-07-12 aorus refresh;
    [[01] - rfsom-01.kicad_sch, [02] - power.kicad_sch, [03] - mcu.kicad_sch, [04] - soc.kicad_sch, [05] - soc-power.kicad_sch, [06] - soc-ps.kicad_sch, [07] - soc-ddr.kicad_sch, [08] - ram.kicad_sch]
2026-08-15 restructured project;
    [[01] - top.kicad_sch, [02] - power.kicad_sch, [03] - mcu.kicad_sch, [04] - soc.kicad_sch, [05] - soc-power.kicad_sch, [06] - soc-ps.kicad_sch, [07] - soc-ddr.kicad_sch, [08] - ram.kicad_sch]
